Zain-Ul-Islam-Siddiqui/Smart-IoT-Audio-Streaming-System/Design Files/IoT-Speaker-v1.4/Renderings/2D_Top_View.PNG.png

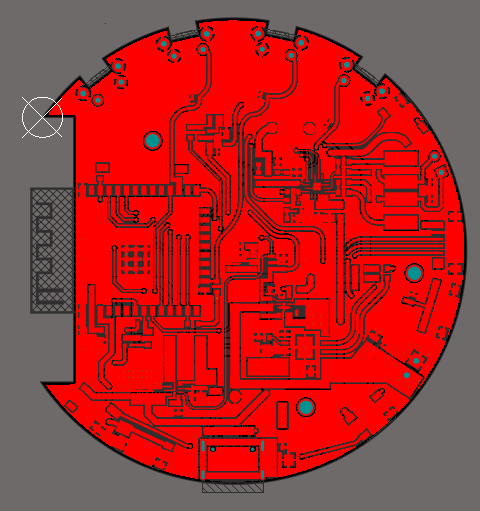
Design Files/IoT-Speaker-v1.4/Renderings/2D_Top_View.PNG.png
