Zain-Ul-Islam-Siddiqui/Smart-IoT-Audio-Streaming-System/Design Files/IoT-Speaker-v1.4/Renderings/3D_Bottom_View.PNG.png

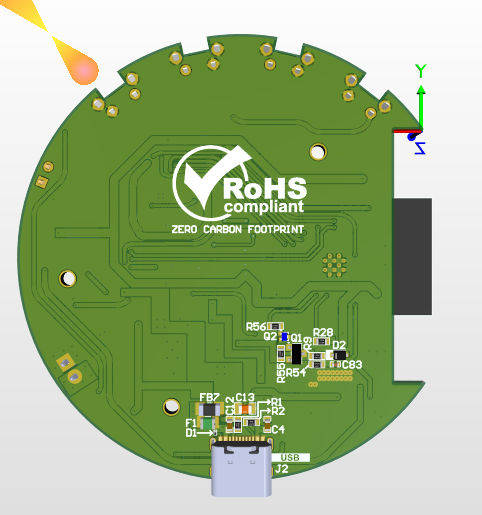
Design Files/IoT-Speaker-v1.4/Renderings/3D_Bottom_View.PNG.png
