Zain-Ul-Islam-Siddiqui/Smart-IoT-Audio-Streaming-System/Design Files/IoT-Speaker-v1.4/BOM/Client BOM IoT-Speaker v1.4.xlsx

 |  | Component list |  | Bill of Materials for Project [IoT-Speaker v1.4]
 |  | Source Data From: |  | IoT-Speaker v1.4
 |  | Project: |  | IoT-Speaker v1.4
 |  | Variant: |  | None
# | Item Type | Designator | Description | Footprint | Manufacturer Part Number | Manufacturer | Value | Links | Quantity | Quantity (5 Boards) | Remarks
1 | Capacitor | C1, C5, C6, C16 | CAP CER 10UF 25V X5R 0805 | Cap-0805 | CC0805KKX5R8BB106 | Yageo | 10uF |  | 4 | 20 | DNP
2 | Capacitor | C2, C3, C7, C18, C20, C83 | CAP CER 0.1UF 25V X5R 0402 | Cap-0402 | CC0402KRX5R8BB104 | Yageo | 100nF |  | 6 | 30 | DNP
3 | Capacitor | C4, C12, C76 | CAP CER 10000PF 50V C0G/NPO 0603 | Cap-0603 | CC0603JRNPO9BN103 | Yageo | 10nF |  | 3 | 15
4 | Capacitor | C9, C15, C17, C19, C21, C22, C24, C78 | CAP CER 10000PF 50V C0G/NPO 0603 | Cap-0402 | CC0402KRX5R8BB104 | Yageo | 100nF |  | 8 | 40
5 | Capacitor | C10, C11 | CAP CER 220PF 50V C0G/NPO 0402 | Cap-0402 | CC0402JRNPO9BN221 | Yageo | 220pF |  | 2 | 10
6 | Capacitor | C13, C103 | CAP CER 10UF 25V X5R 0805 | Cap-0805 | CC0805KKX5R8BB106 | Yageo | 10uF |  | 2 | 10
7 | Capacitor | C14, C75, C102 | CAP CER 1UF 25V X5R 0603 | Cap-0603 | CC0603KRX5R8BB105 | Yageo | 1uF |  | 3 | 15
8 | Capacitor | C23, C77 | CAP CER 22UF 10V X5R 0603 | Cap-0603 | CC0603MRX5R6BB226 | Yageo | 22uF |  | 2 | 10
9 | Capacitor | C25, C26 | CAP CER 22UF 10V X5R 0603 | Cap-0603 | CC0603MRX5R6BB226 | Yageo | 22uF |  | 2 | 10 | DNP
10 | Capacitor | C74 | CAP CER 1UF 25V X5R 0603 | Cap-0603 | CC0603KRX5R8BB105 | Yageo | 1uF |  | 1 | 5 | DNP
11 | Capacitor | C79 | CAP CER 4700PF 1KV X7R 1206 | Cap-1206 | CC1206KKX7RCBB472 | Yageo | 4.7nF |  | 1 | 5
12 | Diode | D1 | TVS DIODE 5VWM 6.3VC DSN0603-2 | DSN0603-2 | PESD5V0H1BSFYL | Nexperia | - |  | 1 | 5
13 | Diode | D2 | DIODE ZENER 3.3V 200MW SOD323F | SOD323F | MM3Z3V3B | ON Semiconductor / Fairchild | - |  | 1 | 5 | DNP
14 | Fuse | F1 | 6V 2A 50A 1W -40℃~+85℃ 4A 4mΩ 5s 45mΩ 0805 Resettable Fuses ROHS | Fuse-0805 | BSMD0805L-200 | BHFUSE | - |  | 1 | 5
15 | Ferrite Bead | FB1, FB2, FB3 | FERRITE BEAD 30 OHM 0603 1LN / Ferrite Beads Multi-Layer 30Ohm 100MHz 1A 0.05Ohm DCR 0603 T/R | IND-0603 (1608 Metric) | BLM18PG300SN1D | Murata | - |  | 3 | 15
16 | Ferrite Bead | FB7 | FERRITE BEAD 120 OHM 1206 1LN | IND-1206 | BLM31PG121SN1L | Murata | - |  | 1 | 5
17 | JST Connector | J1 | Conn Shrouded Header (4 Sides) HDR 2 POS 2.5mm Solder ST Thru-Hole Box | B2B-XH-A(LF)(SN)_ | B2B-XH-A(LF)(SN) | JST | - |  | 1 | 5 | DNP
18 | USB Connector | J2 | 250mA 1 16 Female Type-C SMD USB Connectors ROHS | TYPE-C-31-M-12_ | TYPE-C-31-M-12 | Korean Hroparts Elec | - |  | 1 | 5
19 | Connector | J3 | 1x6P SH 1 1mm 6 SMD,P=1mm Wire To Board / Wire To Wire Connector ROHS | Voltlink Target | C145963 | BOOMELE | - |  | 1 | 5
20 | Header | J9 | CONN HEADER VERT 2POS 2.54MM | HDR1X2_ | 61300211121 | Wurth Electronics | - |  | 1 | 5
21 | INductor | L1 | 5.15A 1uH ±30% SMD Power Inductors ROHS | MPIT6045-1R0N-LF | MPIT6045-1R0N-LF | microgate | 1uH |  | 1 | 5 | DNP
22 | Inductor | L2, L3 | FIXED IND 33UH 500MA 275MOHM SMD | VLCF5024T-330MR50-2 | VLCF5024T-330MR50-2 | TDK | 33uH |  | 2 | 10
23 | LED | LED1 | Emerald 0603 Light Emitting Diodes (LED) ROHS | LED-0603 | NCD0603G2 | Foshan NationStar Optoelectronics | - |  | 1 | 5 | DNP
24 | LED | LED2 | 0603 Light Emitting Diodes (LED) ROHS | LED-0603 | NCD0603R3 | Foshan NationStar Optoelectronics | - |  | 1 | 5 | DNP
25 | RGB LED | LED3, LED4, LED5 | SMD5050 Light Emitting Diodes (LED) ROHS | WS2812B-XF02/W | WS2812B-XF02/W | Worldsemi | - |  | 3 | 15
26 | Mosfet | Q1 | 30V 4.1A 60mΩ@10V,4.1A 350mW 3V@250uA P Channel SOT-23 MOSFETs ROHS | SOT-23 | AO3407 | Guangdong Hottech | - |  | 1 | 5 | DNP
27 | Mosfet | Q2 | 40V 100mW 100@10mA,1V 200mA 300MHz 300mV@50mA,5mA NPN -55℃~+150℃@(Tj) SOT-723 Bipolar Transistors - BJT ROHS | SOT-723 | MMBT3904M | TECH PUBLIC | - |  | 1 | 5 | DNP
28 | Mosfet | Q3 | 40V 100mW 100@10mA,1V 200mA 300MHz 300mV@50mA,5mA NPN -55℃~+150℃@(Tj) SOT-723 Bipolar Transistors - BJT ROHS | SOT-723 | MMBT3904M | TECH PUBLIC | - |  | 1 | 5
29 | Mosfet | Q6 | N-CHANNEL 20-V (D-S) MOSFET | Sot-23 | SI2302CDS | TECH PUBLIC | - |  | 1 | 5
30 | Resistor | R1, R2 | RES 5.1K OHM 1% 1/10W 0603 | Res-0603 | RC0603FR-075K1L | Yageo | 5.1K |  | 2 | 10
31 | Resistor | R4 | RES SMD 330R 100 mW 0603 | Res-0603 | RC0603JR-07330RL | Yageo | 330R |  | 1 | 5 | DNP
32 | Resistor | R5 | Thick Film Resistors 75V 1.2kΩ 0603 Chip Resistor - Surface Mount ROHS | Res-0603 | 0603WAF1201T5E | UNI-ROYAL | 1.2K |  | 1 | 5 | DNP
33 | Resistor | R6 | RES SMD 10K Ohm 1% 1/10W 0603 | Res-0603 | RC0603FR-0710KL | Yageo | 10K |  | 1 | 5 | DNP
34 | Resistor | R7 | ±1% 732kΩ 0402 Chip Resistor - Surface Mount ROHS | Res-0402 | FRC0402F7323TS | FOJAN | 732K |  | 1 | 5 | DNP
35 | Resistor | R8 | RES SMD 100K OHM 0.1% 1/10W 0603 | Res-0603 | RT0603BRD07100KL | Yageo | 100K |  | 1 | 5 | DNP
36 | Resistor | R9, R54 | RES 47K OHM 5% 1/10W 0603 | Res-0603 | RC0603JR-0747KL | Yageo | 47K |  | 2 | 10 | DNP
37 | Resistor | R10, R11 | RES SMD 4.7K OHM 5% 1/10W 0603 | Res-0603 | RC0603JR-074K7L | Yageo | 4.7K |  | 2 | 10
38 | Resistor | R12 | RES 47K OHM 5% 1/10W 0603 | Res-0603 | RC0603JR-0747KL | Yageo | 47K |  | 1 | 5
39 | Resistor | R13, R14 | RES 0 OHM JUMPER 1/10W 0603 | Res-0603 | RC0603JR-070RL | Yageo | 0R |  | 2 | 10
40 | Resistor | R18, R19, R20, R21, R22 | RES SMD 10K Ohm 1% 1/10W 0603 | Res-0603 | RC0603FR-0710KL | Yageo | 10K |  | 5 | 25
41 | Resistor | R26, R27 | RES 10K OHM 1% 1/16W 0402 | Res-0402 | RC0402FR-0710KL | Yageo | 10K |  | 2 | 10
42 | Resistor | R28 | RES SMD 1K OHM 1% 1/10W 0603 | Res-0603 | RC0603FR-071KL | Yageo | 1K |  | 1 | 5
43 | Resistor | R29, R31, R34, R36, R37, R38 | RES SMD 0R, 1%, 0.1W, 0603 | Res-0603 | RC0603FR-070RL | Yageo | 0R |  | 6 | 30 | DNP
44 | Resistor | R30, R32, R35, R39 | RES SMD 0R, 1%, 0.1W, 0603 | Res-0603 | RC0603FR-070RL | Yageo | 0R |  | 4 | 20
45 | Resistor | R55 | RES SMD 1K OHM 1% 1/10W 0603 | Res-0603 | RC0603FR-071KL | Yageo | 1K |  | 1 | 5 | DNP
46 | Resistor | R56 | RES SMD 4.7K OHM 5% 1/10W 0603 | Res-0603 | RC0603JR-074K7L | Yageo | 4.7K |  | 1 | 5 | DNP
47 | Resistor | R65, R69 | RES SMD 1M OHM 1% 1/10W 0603 | Res-0603 | RC0603FR-071ML | Yageo | 1M |  | 2 | 10
48 | Resistor | R66, R67 | RES SMD 100K OHM 0.1% 1/10W 0603 | Res-0603 | RT0603BRD07100KL | Yageo | 100K |  | 2 | 10
49 | Switch | SW1 | No NO 50mA 4.5mm 100000 260gf 12V -30℃~+85℃ 4.5mm 4.3mm Black Round Button Brick nogging SPST SMD Tactile Switches ROHS | TS-1109S-C-B | TS-1109S-C-B | XKB Connectivity | - |  | 1 | 5
50 | Tactile Switch | SW4, SW5, SW6, SW8 | Plugin-4P,7.7x3.5mm Tactile Switches ROHS | TS-1087E-B3D2 | TS-1087E-B3D2 | Yuandy | - |  | 4 | 20
51 | Switch | SW7 | No NO 50mA 4.5mm 100000 160gf 12V -30℃~+85℃ 4.5mm 8mm Black Round Button Brick nogging SPST SMD Tactile Switches ROHS | TS-1109S-B-J_ | TS-1109S-B-J | XKB Connectivity | - |  | 1 | 5
52 | Mosfet | U1 | ESOP-8 Battery Management ICs ROHS | ESOP-8 | TP4056-42-ESOP8 | TOPPOWER | - |  | 1 | 5
53 | IC | U2 | OR Controller N+1 ORing Controller N-Channel 2:1 SOT-583 | SOT-583 | LM66200DRLR | Texas Instruments | - |  | 1 | 5 | DNP
54 | IC | U3 | 8-A boost converter with 0.5-V ultra-low input voltage 7-VQFN-HR -40 to 125 | 7-VQFN-HR (2x2) | TPS61022RWUR | Texas Instruments | - |  | 1 | 5 | DNP
55 | Module | U4 | RF TXRX MODULE BT PCB TRACE SMD | 38-SMD Module | ESP32-WROOM-32E-N8R2 | Espressif Systems | - |  | 1 | 5
56 | IC | U7 | SPX3819 Series 3.3 V 500 mA Fixed Output SMT LDO Regulator - SOT-23-5 | SOT-23-5 | SPX3819M5-L-3-3/TR | MaxLinear | - |  | 1 | 5
57 | IC | U8 | IC CNTRLR ON/OFF W/DEB TSOT23-6 | TSOT-23-6 | MAX16054AZT+T | Maxim | - |  | 1 | 5
58 | IC | U16 | Audio Amplifier, 1 Func, PQCC16 | TQFN-16-EP(3x3) | MAX98357AETE+T | Maxim | - |  | 1 | 5
59 | Speaker | Peripheral | Speakers ROHS | - | FS40DS0430-H18.8 |  |  |  | 1 | 5
60 | Battery | Peripheral | 803450 3.7V 1500mAh Lithium Polymer Rechargeable Battery For MP3 GPS Massager Camera Power Bank Laptop Speaker Lipo Li ion Cell | - | - | - | - | Aliexpress (https://vi.aliexpress.com/item/1005006415551699.html) | 1 | 5
61 | USB Cable | Peripheral | 3A USB Type C Fast Charging Cable Quick Charger QC3.0 USB C Data Cable for Xiaomi Huawei Samsung Tablets Laptops 1M | - | - | - | - | Aliexpress (https://vi.aliexpress.com/item/1005006383634012.html?utparam-url=scene%3Asearch%7Cquery_from%3A) | 1 | 1
62 | Screw | Peripheral | M2 Thread Length 16mm/ Head Dia 4mm | - | M2 (16mm) | - | - | Aliexpress (https://vi.aliexpress.com/item/32810852732.html?pdp_npi=4) | 3 | 15
63 |  |  | M3 Thread Length 20mm/ Head Dia 5.6mm | - | M3 (20mm) | - | - | Aliexpress (https://vi.aliexpress.com/item/32810852732.html?pdp_npi=4) | 2 | 10
64 |  |  | M Thread Length 4mm/ Head Dia 5.6mm | - | M3 (4mm) | - | - | Aliexpress (https://vi.aliexpress.com/item/32810852732.html?pdp_npi=4) | 4 | 20
