Zain-Ul-Islam-Siddiqui/Smart-IoT-Audio-Streaming-System/Design Files/IoT-Speaker-v1.4/BOM/eSpark BOM IoT-Speaker v1.3.xlsx

Sheet: 5 Boards
 |  | Component list |  | Bill of Materials for Project [IoT-Speaker v1.3]
 |  | Source Data From: |  | IoT-Speaker v1.3
 |  | Project: |  | IoT-Speaker v1.3
 |  | Variant: |  | None
# | Item Type | Designator | Description | Footprint | Manufacturer Part Number | Manufacturer | Alternate Part Number | LCSC Part Number | Value | Quantity | Quantity (5 Boards) | MOQ (5 Boards) | Links | Unit Cost (5 Boards) | Total Cost (5 Boards) | Remarks | Reviewer Remarks
1 | Capacitor | C1, C5, C6, C13, C16, C103 | CAP CER 10UF 25V X5R 0805 | Cap-0805 | CC0805KKX5R8BB106 | Yageo | - | C89831 | 10uF | 6 | 30 | 40 | LCSC (https://www.lcsc.com/product-detail/Multilayer-Ceramic-Capacitors-MLCC-SMD-SMT_YAGEO-CC0805KKX5R8BB106_C89831.html) | $0.0355 | $1.4200
2 | Capacitor | C2, C3, C7, C9, C15, C17, C18, C19, C20, C21, C22, C24, C78, C83 | CAP CER 0.1UF 25V X5R 0402 | Cap-0402 | CC0402KRX5R8BB104 | Yageo | - | C106256 | 100nF | 14 | 70 | 100 | LCSC (https://www.lcsc.com/product-detail/Multilayer-Ceramic-Capacitors-MLCC-SMD-SMT_YAGEO-CC0402KRX5R8BB104_C106256.html) | $0.0018 | $0.1800
3 | Capacitor | C4, C12, C76 | CAP CER 10000PF 50V C0G/NPO 0603 | Cap-0603 | CC0603JRNPO9BN103 | Yageo | - | C389113 | 10nF | 3 | 15 | 50 | LCSC (https://www.lcsc.com/product-detail/Multilayer-Ceramic-Capacitors-MLCC-SMD-SMT_YAGEO-CC0603JRNPO9BN103_C389113.html) | $0.0166 | $0.8300
4 | Capacitor | C10, C11 | CAP CER 220PF 50V C0G/NPO 0402 | Cap-0402 | CC0402JRNPO9BN221 | Yageo | - | C107001 | 220pF | 2 | 10 | 100 | LCSC (https://www.lcsc.com/product-detail/Multilayer-Ceramic-Capacitors-MLCC-SMD-SMT_YAGEO-CC0402JRNPO9BN221_C107001.html) | $0.0023 | $0.2300
5 | Capacitor | C14, C74, C75, C102 | CAP CER 1UF 25V X5R 0603 | Cap-0603 | CC0603KRX5R8BB105 | Yageo | - | C14664 | 1uF | 4 | 20 | 100 | LCSC (https://www.lcsc.com/product-detail/Multilayer-Ceramic-Capacitors-MLCC-SMD-SMT_YAGEO-CC0603KRX5R8BB105_C14664.html) | $0.0052 | $0.5200
6 | Capacitor | C23, C25, C26, C77 | CAP CER 22UF 10V X5R 0603 | Cap-0603 | CC0603MRX5R6BB226 | Yageo | - | C109447 | 22uF | 4 | 20 | 40 | LCSC (https://www.lcsc.com/product-detail/Multilayer-Ceramic-Capacitors-MLCC-SMD-SMT_YAGEO-CC0603MRX5R6BB226_C109447.html) | $0.0452 | $1.8080
7 | Capacitor | C79 | CAP CER 4700PF 1KV X7R 1206 | Cap-1206 | CC1206KKX7RCBB472 | Yageo | - | C107198 | 4.7nF | 1 | 5 | 50 | LCSC (https://www.lcsc.com/product-detail/Multilayer-Ceramic-Capacitors-MLCC-SMD-SMT_YAGEO-CC1206KKX7RCBB472_C107198.html) | $0.0191 | $0.9550
8 | Diode | D1 | TVS DIODE 5VWM 6.3VC DSN0603-2 | DSN0603-2 | PESD5V0H1BSFYL | Nexperia | - | C477989 | - | 1 | 5 | 10 | LCSC (https://www.lcsc.com/product-detail/ESD-Protection-Devices_Nexperia-PESD5V0H1BSF_C477989.html) | $0.0341 | $0.3410
9 | Diode | D2 | DIODE ZENER 3.3V 200MW SOD323F | SOD323F | MM3Z3V3B | ON Semiconductor / Fairchild | - | C2978865 | - | 1 | 5 | 10 | LCSC (https://www.lcsc.com/product-detail/Zener-Diodes_EIC-Semicon-MM3Z3V3B_C2978865.html) | $0.0404 | $0.4040
10 | Fuse | F1 | 6V 2A 50A 1W -40℃~+85℃ 4A 4mΩ 5s 45mΩ 0805 Resettable Fuses ROHS | Fuse-0805 | BSMD0805L-200 | BHFUSE | - | C2757931 | - | 1 | 5 | 10 | LCSC (https://www.lcsc.com/product-detail/Resettable-Fuses_BHFUSE-BSMD0805L-200_C2757931.html) | $0.0933 | $0.9330
11 | Ferrite Bead | FB1, FB2, FB3 | FERRITE BEAD 30 OHM 0603 1LN / Ferrite Beads Multi-Layer 30Ohm 100MHz 1A 0.05Ohm DCR 0603 T/R | IND-0603 (1608 Metric) | BLM18PG300SN1D | Murata | - | C17305 | - | 3 | 15 | 100 | LCSC (https://www.lcsc.com/product-detail/Ferrite-Beads_Murata-Electronics-BLM18PG300SN1D_C17305.html) | $0.0071 | $0.7100
12 | Ferrite Bead | FB7 | FERRITE BEAD 120 OHM 1206 1LN | IND-1206 | BLM31PG121SN1L | Murata | - | C85841 | 100MHz | 1 | 5 | 10 | LCSC (https://www.lcsc.com/product-detail/Ferrite-Beads_Murata-Electronics-BLM31PG121SN1L_C85841.html) | $0.0669 | $0.6690
13 | JST Connector | J1 | Conn Shrouded Header (4 Sides) HDR 2 POS 2.5mm Solder ST Thru-Hole Box | B2B-XH-A(LF)(SN)_ | B2B-XH-A(LF)(SN) | JST | - | C158012 | - | 1 | 5 | 20 | LCSC (https://www.lcsc.com/product-detail/Wire-To-Board-Wire-To-Wire-Connector_JST-Sales-America-B2B-XH-A-LF-SN_C158012.html) | $0.0328 | $0.6560
14 | USB Connector | J2 | 250mA 1 16 Female Type-C SMD USB Connectors ROHS | TYPE-C-31-M-12_ | TYPE-C-31-M-12 | Korean Hroparts Elec | - | C165948 | - | 1 | 5 | 10 | LCSC (https://www.lcsc.com/product-detail/USB-Connectors_Korean-Hroparts-Elec-TYPE-C-31-M-12_C165948.html) | $0.1612 | $1.6120
15 | Connector | J3 | 1x6P SH 1 1mm 6 SMD,P=1mm Wire To Board / Wire To Wire Connector ROHS | Voltlink Target | C145963 | BOOMELE | - | C145963 | - | 1 | 5 | 12 | LCSC (https://www.lcsc.com/product-detail/Wire-To-Board-Wire-To-Wire-Connector_BOOMELE-Boom-Precision-Elec-C145963_C145963.html) | $0.0680 | $0.8160
16 | Header | J9 | CONN HEADER VERT 2POS 2.54MM | HDR1X2_ | ~~61300211121~~ | Wurth Electronics | B-2100S02P-A110 | C124375 | - | 1 | 5 | 20 | LCSC (https://www.lcsc.com/product-detail/span-style-background-color-ff0-Pin-span-Headers_Ckmtw-Shenzhen-Cankemeng-B-2100S02P-A110_C124375.html) | $0.0220 | $0.4400
17 | INductor | L1 | 5.15A 1uH ±30% SMD Power Inductors ROHS | MPIT6045-1R0N-LF | MPIT6045-1R0N-LF | microgate | - | C486570 | 1uH | 1 | 5 | 10 | LCSC (https://www.lcsc.com/product-detail/Power-Inductors_microgate-MPIT6045-1R0N-LF_C486570.html) | $0.0726 | $0.7260
18 | Inductor | L2, L3 | FIXED IND 33UH 500MA 275MOHM SMD | VLCF5024T-330MR50-2 | VLCF5024T-330MR50-2 | TDK | - | C2046704 | 33uH | 2 | 10 | 11 | LCSC (https://www.lcsc.com/product-detail/Inductors-SMD_TDK-VLCF5024T-330MR50-2_C2046704.html) | $0.4169 | $4.5859
19 | LED | LED2 | 0603 Light Emitting Diodes (LED) ROHS | LED-0603 | NCD0603R3 | Foshan NationStar Optoelectronics | - | C3151730 | - | 1 | 5 | 20 | LCSC (https://www.lcsc.com/product-detail/Light-Emitting-Diodes-LED_Foshan-NationStar-Optoelectronics-NCD0603R3_C3151730.html) | $0.0208 | $0.4160
20 | RGB LED | LED3, LED4, LED5 | SMD5050 Light Emitting Diodes (LED) ROHS | WS2812B-XF02/W | WS2812B-XF02/W | Worldsemi | - | C4154882 | - | 3 | 15 | 20 | LCSC (https://www.lcsc.com/product-detail/Light-Emitting-Diodes-LED_Worldsemi-WS2812B-XF02-W_C4154882.html) | $0.0617 | $1.2340
21 | Mosfet | Q1 | 30V 4.1A 60mΩ@10V,4.1A 350mW 3V@250uA P Channel SOT-23 MOSFETs ROHS | SOT-23 | AO3407 | Guangdong Hottech | - | C181093 | - | 1 | 5 | 20 | LCSC (https://www.lcsc.com/product-detail/MOSFETs_Guangdong-Hottech-AO3407_C181093.html) | $0.0325 | $0.6500
22 | Mosfet | Q2, Q3 | 40V 100mW 100@10mA,1V 200mA 300MHz 300mV@50mA,5mA NPN -55℃~+150℃@(Tj) SOT-723 Bipolar Transistors - BJT ROHS | SOT-723 | MMBT3904M | TECH PUBLIC | - | C2923360 | - | 2 | 10 | 20 | LCSC (https://www.lcsc.com/product-detail/Bipolar-Transistors-BJT_TECH-PUBLIC-MMBT3904M_C2923360.html) | $0.0335 | $0.6700
23 | Mosfet | Q6 | N-CHANNEL 20-V (D-S) MOSFET | Sot-23 | SI2302CDS | TECH PUBLIC | - | C5310968 | - | 1 | 5 | 20 | LCSC (https://www.lcsc.com/product-detail/MOSFETs_TECH-PUBLIC-SI2302CDS_C5310968.html) | $0.0341 | $0.6820
24 | Resistor | R1, R2 | RES 5.1K OHM 1% 1/10W 0603 | Res-0603 | RC0603FR-075K1L | Yageo | - | C105580 | 5.1K | 2 | 10 | 100 | LCSC (https://www.lcsc.com/product-detail/Chip-Resistor-Surface-Mount_YAGEO-RC0603FR-075K1L_C105580.html) | $0.0013 | $0.1300
25 | Resistor | R4 | RES SMD 330R 100 mW 0603 | Res-0603 | RC0603JR-07330RL | Yageo | - | C105879 | 330R | 1 | 5 | 100 | LCSC (https://www.lcsc.com/product-detail/Chip-Resistor-Surface-Mount_YAGEO-RC0603JR-07330RL_C105879.html) | $0.0011 | $0.1100
26 | Resistor | R5 | Thick Film Resistors 75V 1.2kΩ 0603 Chip Resistor - Surface Mount ROHS | Res-0603 | 0603WAF1201T5E | UNI-ROYAL | - | C22765 | 1.2K | 1 | 5 | 100 | LCSC (https://www.lcsc.com/product-detail/Chip-Resistor-Surface-Mount_UNI-ROYAL-Uniroyal-Elec-0603WAF1201T5E_C22765.html) | $0.0011 | $0.1100
27 | Resistor | R6, R18, R19, R20, R21, R22 | RES SMD 10K Ohm 1% 1/10W 0603 | Res-0603 | RC0603FR-0710KL | Yageo | - | C98220 | 10K | 6 | 30 | 100 | LCSC (https://www.lcsc.com/product-detail/Chip-Resistor-Surface-Mount_YAGEO-RC0603FR-0710KL_C98220.html) | $0.0010 | $0.1000
28 | Resistor | R7 | ±1% 732kΩ 0402 Chip Resistor - Surface Mount ROHS | Res-0402 | FRC0402F7323TS | FOJAN | - | C5159692 | 732K | 1 | 5 | 10 | LCSC (https://www.lcsc.com/product-detail/Chip-Resistor-Surface-Mount_FOJAN-FRC0402F7323TS_C5159692.html) | $0.0004 | $0.0040
29 | Resistor | R8, R66, R67 | RES SMD 100K OHM 0.1% 1/10W 0603 | Res-0603 | RT0603BRD07100KL | Yageo | - | C122538 | 100K | 3 | 15 | 20 | LCSC (https://www.lcsc.com/product-detail/Chip-Resistor-Surface-Mount_YAGEO-RT0603BRD07100KL_C122538.html) | $0.0211 | $0.4220
30 | Resistor | R9, R12, R54 | RES 47K OHM 5% 1/10W 0603 | Res-0603 | RC0603JR-0747KL | Yageo | - | C127447 | 47K | 3 | 15 | 100 | LCSC (https://www.lcsc.com/product-detail/Chip-Resistor-Surface-Mount_YAGEO-RC0603JR-0747KL_C127447.html) | $0.0011 | $0.1100
31 | Resistor | R10, R11, R56 | RES SMD 4.7K OHM 5% 1/10W 0603 | Res-0603 | RC0603JR-074K7L | Yageo | - | C105428 | 4.7K | 3 | 15 | 100 | LCSC (https://www.lcsc.com/product-detail/Chip-Resistor-Surface-Mount_YAGEO-RC0603JR-074K7L_C105428.html) | $0.0011 | $0.1100
32 | Resistor | R26, R27 | RES 10K OHM 1% 1/16W 0402 | Res-0402 | RC0402FR-0710KL | Yageo | - | C60490 | 10K | 2 | 10 | 100 | LCSC (https://www.lcsc.com/product-detail/Chip-Resistor-Surface-Mount_YAGEO-RC0402FR-0710KL_C60490.html) | $0.0006 | $0.0600
33 | Resistor | R28, R55 | RES SMD 1K OHM 1% 1/10W 0603 | Res-0603 | RC0603FR-071KL | Yageo | - | C22548 | 1K | 2 | 10 | 100 | LCSC (https://www.lcsc.com/product-detail/Chip-Resistor-Surface-Mount_YAGEO-RC0603FR-071KL_C22548.html) | $0.0010 | $0.1000
34 | Resistor | R30, R32, R35, R39 | RES SMD 0R, 1%, 0.1W, 0603 | Res-0603 | ~~RC0603FR-070RL~~ | Yageo | 0603WAF0000T5E | C21189 | 0R | 4 | 20 | 100 | LCSC (https://www.lcsc.com/product-detail/Chip-Resistor-Surface-Mount_UNI-ROYAL-Uniroyal-Elec-0603WAF0000T5E_C21189.html) | $0.0011 | $0.1100
35 | Resistor | R65, R69 | RES SMD 1M OHM 1% 1/10W 0603 | Res-0603 | RC0603FR-071ML | Yageo | - | C105578 | 1M | 2 | 10 | 100 | LCSC (https://www.lcsc.com/product-detail/Chip-Resistor-Surface-Mount_YAGEO-RC0603FR-071ML_C105578.html) | $0.0012 | $0.1200
36 | Switch | SW1 | No NO 50mA 4.5mm 100000 260gf 12V -30℃~+85℃ 4.5mm 4.3mm Black Round Button Brick nogging SPST SMD Tactile Switches ROHS | TS-1109S-C-B | TS-1109S-C-B | XKB Connectivity | - | C381037 | - | 1 | 5 | 20 | LCSC (https://www.lcsc.com/product-detail/Tactile-Switches_XKB-Connectivity-TS-1109S-C-B_C381037.html) | $0.0217 | $0.4340
37 | Tactile Switch | SW4, SW5, SW6, SW8 | Plugin-4P,7.7x3.5mm Tactile Switches ROHS | TS-1087E-B3D2 | TS-1087E-B3D2 | Yuandi | - | - | - | 4 | 20 | 21 | LCSC (https://www.lcsc.com/product-detail/Tactile-Switches_Yuandi-TS-1087E-B3D2_C541963.html) | $0.6100 | $12.8100
38 | Switch | SW7 | No NO 50mA 4.5mm 100000 160gf 12V -30℃~+85℃ 4.5mm 8mm Black Round Button Brick nogging SPST SMD Tactile Switches ROHS | TS-1109S-B-J_ | TS-1109S-B-J | XKB Connectivity | - | C480323 | - | 1 | 5 | 10 | LCSC (https://www.lcsc.com/product-detail/Tactile-Switches_XKB-Connectivity-TS-1109S-B-J_C480323.html) | $0.0402 | $0.4020
39 | Mosfet | U1 | ESOP-8 Battery Management ICs ROHS | ESOP-8 | TP4056-42-ESOP8 | TOPPOWER | - | C16581 | - | 1 | 5 | 10 | LCSC (https://www.lcsc.com/product-detail/Battery-Management-ICs_TOPPOWER-Nanjing-Extension-Microelectronics-TP4056-42-ESOP8_C16581.html) | $0.1760 | $1.7600
40 | IC | U2 | OR Controller N+1 ORing Controller N-Channel 2:1 SOT-583 | SOT-583 | LM66200DRLR | Texas Instruments | - | C3235556 | - | 1 | 5 | 6 | LCSC (https://www.lcsc.com/product-detail/Power-Distribution-Switches_Texas-Instruments-LM66200DRLR_C3235556.html) | $0.4169 | $2.5014
41 | IC | U3 | 8-A boost converter with 0.5-V ultra-low input voltage 7-VQFN-HR -40 to 125 | 7-VQFN-HR (2x2) | TPS61022RWUR | Texas Instruments | - | C915088 | - | 1 | 5 | 6 | LCSC (https://www.lcsc.com/product-detail/DC-DC-Converters_Texas-Instruments-TPS61022RWUR_C915088.html) | $0.6046 | $3.6276
42 | Module | U4 | RF TXRX MODULE BT PCB TRACE SMD | 38-SMD Module | ESP32-WROOM-32E-N8R2 | Espressif Systems | - | C5361945 | - | 1 | 5 | 6 | LCSC (https://www.lcsc.com/product-detail/WiFi-Modules_Espressif-Systems-ESP32-WROOM-32E-N8R2_C5361945.html) | $3.3075 | $19.8450
43 | IC | U7 | SPX3819 Series 3.3 V 500 mA Fixed Output SMT LDO Regulator - SOT-23-5 | SOT-23-5 | SPX3819M5-L-3-3/TR | MaxLinear | - | C9055 | - | 1 | 5 | 6 | LCSC (https://www.lcsc.com/product-detail/Linear-Voltage-Regulators-LDO_MaxLinear-SPX3819M5-L-3-3-TR_C9055.html) | $0.1268 | $0.7608
44 | IC | U8 | IC CNTRLR ON/OFF W/DEB TSOT23-6 | TSOT-23-6 | MAX16054AZT+T | Maxim | - | C79401 | - | 1 | 5 | 6 | LCSC (https://www.lcsc.com/product-detail/Interface-Specialized_Analog-Devices-MAX16054AZT-T_C79401.html) | $1.4398 | $8.6388
45 | IC | U16 | Audio Amplifier, 1 Func, PQCC16 | TQFN-16-EP(3x3) | MAX98357AETE+T | Maxim | - | C910544 | - | 1 | 5 | 6 | LCSC (https://www.lcsc.com/product-detail/Audio-Power-OpAmps_Analog-Devices-Inc-Maxim-Integrated-MAX98357AETE-T_C910544.html) | $1.0500 | $6.3000
46 | Speaker | Peripheral | Speakers ROHS | - | FS40DS0430-H18.8 | - | - | C969979 | - | 1 | 5 | 6 | LCSC (https://www.lcsc.com/product-detail/Speakers_FUET-FS40DS0430-H18-8_C969979.html) | $1.9410 | $11.6460
47 | Battery | Peripheral | 803450 3.7V 1500mAh Lithium Polymer Rechargeable Battery For MP3 GPS Massager Camera Power Bank Laptop Speaker Lipo Li ion Cell | - | - | - | - | - | - | 1 | 5 | 5 | Aliexpress (https://vi.aliexpress.com/item/1005006415551699.html) | $3.0800 | $15.4000
48 | Charger | Peripheral | Universal 5V 1A 2A Type C USB Charger Mobile Phone Wall Travel Power Adapter Charger EU/US Plug For Huawei Xiaomi iPhone Samsung (2A Rating Selected) | - | - | - | - | - | - | 1 | 5 | 1 | Aliexpress (https://vi.aliexpress.com/item/1005005257036835.html) | $0.6600 | $0.6600
49 | Screw | Peripheral | M2 Thread Length 16mm/ Head Dia 4mm | - | M2 (16mm) | - | - | - | - | 3 | 15 | 50 | Aliexpress (https://vi.aliexpress.com/item/32810852732.html?pdp_npi=4) | $0.0254 | $1.2700
50 |  |  | M3 Thread Length 20mm/ Head Dia 5.6mm | - | M3 (20mm) | - | - | - | - | 2 | 10 | 50 | Aliexpress (https://vi.aliexpress.com/item/32810852732.html?pdp_npi=4) | $0.0368 | $1.8400
51 |  |  | M Thread Length 4mm/ Head Dia 5.6mm | - | M3 (4mm) | - | - | - | - | 4 | 20 | 50 | Aliexpress (https://vi.aliexpress.com/item/32810852732.html?pdp_npi=4) | $0.0144 | $0.7200
 |  |  |  |  |  |  |  |  |  |  |  | Total Component Cost |  |  | $111.59
 |  |  |  |  |  |  |  |  |  |  |  | Single Board Cost |  |  | $22.32

Sheet: 100 Boards
 |  | Component list |  | Bill of Materials for Project [IoT-Speaker v1.3]
 |  | Source Data From: |  | IoT-Speaker v1.3
 |  | Project: |  | IoT-Speaker v1.3
 |  | Variant: |  | None
# | Item Type | Designator | Description | Footprint | Manufacturer Part Number | Manufacturer | Alternate Part Number | LCSC Part Number | Value | Quantity | Quantity (100 Boards) | MOQ (100 Boards) | Links | Unit Cost (100 Boards) | Total Cost (100 Boards) | Remarks | Reviewer Remarks
1 | Capacitor | C1, C5, C6, C13, C16, C103 | CAP CER 10UF 25V X5R 0805 | Cap-0805 | CC0805KKX5R8BB106 | Yageo | - | C89831 | 10uF | 6 | 600 | 620 | LCSC (https://www.lcsc.com/product-detail/Multilayer-Ceramic-Capacitors-MLCC-SMD-SMT_YAGEO-CC0805KKX5R8BB106_C89831.html) | $0.0258 | $15.9960
2 | Capacitor | C2, C3, C7, C9, C15, C17, C18, C19, C20, C21, C22, C24, C78, C83 | CAP CER 0.1UF 25V X5R 0402 | Cap-0402 | CC0402KRX5R8BB104 | Yageo | - | C106256 | 100nF | 14 | 1400 | 1500 | LCSC (https://www.lcsc.com/product-detail/Multilayer-Ceramic-Capacitors-MLCC-SMD-SMT_YAGEO-CC0402KRX5R8BB104_C106256.html) | $0.0015 | $2.2500
3 | Capacitor | C4, C12, C76 | CAP CER 10000PF 50V C0G/NPO 0603 | Cap-0603 | CC0603JRNPO9BN103 | Yageo | - | C389113 | 10nF | 3 | 300 | 350 | LCSC (https://www.lcsc.com/product-detail/Multilayer-Ceramic-Capacitors-MLCC-SMD-SMT_YAGEO-CC0603JRNPO9BN103_C389113.html) | $0.0166 | $5.8100
4 | Capacitor | C10, C11 | CAP CER 220PF 50V C0G/NPO 0402 | Cap-0402 | CC0402JRNPO9BN221 | Yageo | - | C107001 | 220pF | 2 | 200 | 300 | LCSC (https://www.lcsc.com/product-detail/Multilayer-Ceramic-Capacitors-MLCC-SMD-SMT_YAGEO-CC0402JRNPO9BN221_C107001.html) | $0.0023 | $0.6900
5 | Capacitor | C14, C74, C75, C102 | CAP CER 1UF 25V X5R 0603 | Cap-0603 | CC0603KRX5R8BB105 | Yageo | - | C14664 | 1uF | 4 | 400 | 500 | LCSC (https://www.lcsc.com/product-detail/Multilayer-Ceramic-Capacitors-MLCC-SMD-SMT_YAGEO-CC0603KRX5R8BB105_C14664.html) | $0.0059 | $2.9500
6 | Capacitor | C23, C25, C26, C77 | CAP CER 22UF 10V X5R 0603 | Cap-0603 | CC0603MRX5R6BB226 | Yageo | - | C109447 | 22uF | 4 | 400 | 410 | LCSC (https://www.lcsc.com/product-detail/Multilayer-Ceramic-Capacitors-MLCC-SMD-SMT_YAGEO-CC0603MRX5R6BB226_C109447.html) | $0.0421 | $17.2610
7 | Capacitor | C79 | CAP CER 4700PF 1KV X7R 1206 | Cap-1206 | CC1206KKX7RCBB472 | Yageo | - | C107198 | 4.7nF | 1 | 100 | 150 | LCSC (https://www.lcsc.com/product-detail/Multilayer-Ceramic-Capacitors-MLCC-SMD-SMT_YAGEO-CC1206KKX7RCBB472_C107198.html) | $0.0191 | $2.8650
8 | Diode | D1 | TVS DIODE 5VWM 6.3VC DSN0603-2 | DSN0603-2 | PESD5V0H1BSFYL | Nexperia | - | C477989 | - | 1 | 100 | 110 | LCSC (https://www.lcsc.com/product-detail/ESD-Protection-Devices_Nexperia-PESD5V0H1BSF_C477989.html) | $0.0274 | $3.0140
9 | Diode | D2 | DIODE ZENER 3.3V 200MW SOD323F | SOD323F | MM3Z3V3B | ON Semiconductor / Fairchild | - | C2978865 | - | 1 | 100 | 110 | LCSC (https://www.lcsc.com/product-detail/Zener-Diodes_EIC-Semicon-MM3Z3V3B_C2978865.html) | $0.0404 | $4.4440
10 | Fuse | F1 | 6V 2A 50A 1W -40℃~+85℃ 4A 4mΩ 5s 45mΩ 0805 Resettable Fuses ROHS | Fuse-0805 | BSMD0805L-200 | BHFUSE | - | C2757931 | - | 1 | 100 | 105 | LCSC (https://www.lcsc.com/product-detail/Resettable-Fuses_BHFUSE-BSMD0805L-200_C2757931.html) | $0.0760 | $7.9800
11 | Ferrite Bead | FB1, FB2, FB3 | FERRITE BEAD 30 OHM 0603 1LN / Ferrite Beads Multi-Layer 30Ohm 100MHz 1A 0.05Ohm DCR 0603 T/R | IND-0603 (1608 Metric) | BLM18PG300SN1D | Murata | - | C17305 | - | 3 | 300 | 400 | LCSC (https://www.lcsc.com/product-detail/Ferrite-Beads_Murata-Electronics-BLM18PG300SN1D_C17305.html) | $0.0071 | $2.8400
12 | Ferrite Bead | FB7 | FERRITE BEAD 120 OHM 1206 1LN | IND-1206 | BLM31PG121SN1L | Murata | - | C85841 | 100MHz | 1 | 100 | 110 | LCSC (https://www.lcsc.com/product-detail/Ferrite-Beads_Murata-Electronics-BLM31PG121SN1L_C85841.html) | $0.0552 | $6.0720
13 | JST Connector | J1 | Conn Shrouded Header (4 Sides) HDR 2 POS 2.5mm Solder ST Thru-Hole Box | Custom | B2B-XH-A(LF)(SN) | JST | - | C158012 | - | 1 | 100 | 120 | LCSC (https://www.lcsc.com/product-detail/Wire-To-Board-Wire-To-Wire-Connector_JST-Sales-America-B2B-XH-A-LF-SN_C158012.html) | $0.0328 | $3.9360
14 | USB Connector | J2 | 250mA 1 16 Female Type-C SMD USB Connectors ROHS | Custom | TYPE-C-31-M-12 | Korean Hroparts Elec | - | C165948 | - | 1 | 100 | 105 | LCSC (https://www.lcsc.com/product-detail/USB-Connectors_Korean-Hroparts-Elec-TYPE-C-31-M-12_C165948.html) | $0.1282 | $13.4610
15 | Connector | J3 | 1x6P SH 1 1mm 6 SMD,P=1mm Wire To Board / Wire To Wire Connector ROHS | Custom | C145963 | BOOMELE | - | C145963 | - | 1 | 100 | 108 | LCSC (https://www.lcsc.com/product-detail/Wire-To-Board-Wire-To-Wire-Connector_BOOMELE-Boom-Precision-Elec-C145963_C145963.html) | $0.0680 | $7.3440
16 | Header | J9 | CONN HEADER VERT 2POS 2.54MM | HDR1X2_ | ~~61300211121~~ | Wurth Electronics | B-2100S02P-A110 | C124375 | - | 1 | 100 | 120 | LCSC (https://www.lcsc.com/product-detail/span-style-background-color-ff0-Pin-span-Headers_Ckmtw-Shenzhen-Cankemeng-B-2100S02P-A110_C124375.html) | $0.0220 | $2.6400
17 | INductor | L1 | 5.15A 1uH ±30% SMD Power Inductors ROHS | Custom | MPIT6045-1R0N-LF | microgate | - | C486570 | 1uH | 1 | 100 | 105 | LCSC (https://www.lcsc.com/product-detail/Power-Inductors_microgate-MPIT6045-1R0N-LF_C486570.html) | $0.0593 | $6.2265
18 | Inductor | L2, L3 | FIXED IND 33UH 500MA 275MOHM SMD | Custom | VLCF5024T-330MR50-2 | TDK | - | C2046704 | 33uH | 2 | 200 | 202 | LCSC (https://www.lcsc.com/product-detail/Inductors-SMD_TDK-VLCF5024T-330MR50-2_C2046704.html) | $0.3246 | $65.5692
19 | LED | LED2 | 0603 Light Emitting Diodes (LED) ROHS | LED-0603 | NCD0603R3 | Foshan NationStar Optoelectronics | - | C3151730 | - | 1 | 100 | 120 | LCSC (https://www.lcsc.com/product-detail/Light-Emitting-Diodes-LED_Foshan-NationStar-Optoelectronics-NCD0603R3_C3151730.html) | $0.0208 | $2.4960
20 | RGB LED | LED3, LED4, LED5 | SMD5050 Light Emitting Diodes (LED) ROHS | Custom | WS2812B-XF02/W | Worldsemi | - | C4154882 | - | 3 | 300 | 310 | LCSC (https://www.lcsc.com/product-detail/Light-Emitting-Diodes-LED_Worldsemi-WS2812B-XF02-W_C4154882.html) | $0.0444 | $13.7640
21 | Mosfet | Q1 | 30V 4.1A 60mΩ@10V,4.1A 350mW 3V@250uA P Channel SOT-23 MOSFETs ROHS | SOT-23 | AO3407 | Guangdong Hottech | - | C181093 | - | 1 | 100 | 120 | LCSC (https://www.lcsc.com/product-detail/MOSFETs_Guangdong-Hottech-AO3407_C181093.html) | $0.0325 | $3.9000
22 | Mosfet | Q2, Q3 | 40V 100mW 100@10mA,1V 200mA 300MHz 300mV@50mA,5mA NPN -55℃~+150℃@(Tj) SOT-723 Bipolar Transistors - BJT ROHS | SOT-723 | MMBT3904M | TECH PUBLIC | - | C2923360 | - | 2 | 200 | 220 | LCSC (https://www.lcsc.com/product-detail/Bipolar-Transistors-BJT_TECH-PUBLIC-MMBT3904M_C2923360.html) | $0.0271 | $5.9620
23 | Mosfet | Q6 | N-CHANNEL 20-V (D-S) MOSFET | Sot-23 | SI2302CDS | TECH PUBLIC | - | C5310968 | - | 1 | 100 | 120 | LCSC (https://www.lcsc.com/product-detail/MOSFETs_TECH-PUBLIC-SI2302CDS_C5310968.html) | $0.0341 | $4.0920
24 | Resistor | R1, R2 | RES 5.1K OHM 1% 1/10W 0603 | Res-0603 | RC0603FR-075K1L | Yageo | - | C105580 | 5.1K | 2 | 200 | 300 | LCSC (https://www.lcsc.com/product-detail/Chip-Resistor-Surface-Mount_YAGEO-RC0603FR-075K1L_C105580.html) | $0.0013 | $0.3900
25 | Resistor | R4 | RES SMD 330R 100 mW 0603 | Res-0603 | RC0603JR-07330RL | Yageo | - | C105879 | 330R | 1 | 100 | 200 | LCSC (https://www.lcsc.com/product-detail/Chip-Resistor-Surface-Mount_YAGEO-RC0603JR-07330RL_C105879.html) | $0.0011 | $0.2200
26 | Resistor | R5 | Thick Film Resistors 75V 1.2kΩ 0603 Chip Resistor - Surface Mount ROHS | Res-0603 | 0603WAF1201T5E | UNI-ROYAL | - | C22765 | 1.2K | 1 | 100 | 200 | LCSC (https://www.lcsc.com/product-detail/Chip-Resistor-Surface-Mount_UNI-ROYAL-Uniroyal-Elec-0603WAF1201T5E_C22765.html) | $0.0011 | $0.2200
27 | Resistor | R6, R18, R19, R20, R21, R22 | RES SMD 10K Ohm 1% 1/10W 0603 | Res-0603 | RC0603FR-0710KL | Yageo | - | C98220 | 10K | 6 | 600 | 700 | LCSC (https://www.lcsc.com/product-detail/Chip-Resistor-Surface-Mount_YAGEO-RC0603FR-0710KL_C98220.html) | $0.0010 | $0.7000
28 | Resistor | R7 | ±1% 732kΩ 0402 Chip Resistor - Surface Mount ROHS | Res-0402 | FRC0402F7323TS | FOJAN | - | C5159692 | 732K | 1 | 100 | 200 | LCSC (https://www.lcsc.com/product-detail/Chip-Resistor-Surface-Mount_FOJAN-FRC0402F7323TS_C5159692.html) | $0.0004 | $0.0800
29 | Resistor | R8, R66, R67 | RES SMD 100K OHM 0.1% 1/10W 0603 | Res-0603 | RT0603BRD07100KL | Yageo | - | C122538 | 100K | 3 | 300 | 320 | LCSC (https://www.lcsc.com/product-detail/Chip-Resistor-Surface-Mount_YAGEO-RT0603BRD07100KL_C122538.html) | $0.0168 | $5.3760
30 | Resistor | R9, R12, R54 | RES 47K OHM 5% 1/10W 0603 | Res-0603 | RC0603JR-0747KL | Yageo | - | C127447 | 47K | 3 | 300 | 400 | LCSC (https://www.lcsc.com/product-detail/Chip-Resistor-Surface-Mount_YAGEO-RC0603JR-0747KL_C127447.html) | $0.0011 | $0.4400
31 | Resistor | R10, R11, R56 | RES SMD 4.7K OHM 5% 1/10W 0603 | Res-0603 | RC0603JR-074K7L | Yageo | - | C105428 | 4.7K | 3 | 300 | 400 | LCSC (https://www.lcsc.com/product-detail/Chip-Resistor-Surface-Mount_YAGEO-RC0603JR-074K7L_C105428.html) | $0.0011 | $0.4400
32 | Resistor | R23, R24, R25, R33 | RES SMD 68 OHM 0.1% 1/16W 0402 | Res-0402 | ~~ERA-2AEB680X~~ | Panasonic | RT0402BRD0768RL | C445573 | 68R | 4 | 400 | 420 | LCSC (https://www.lcsc.com/product-detail/Chip-span-style-background-color-ff0-Resistor-span-Surface-Mount_YAGEO-RT0402BRD0768RL_C852891.html) | $0.0204 | $8.5680
33 | Resistor | R26, R27 | RES 10K OHM 1% 1/16W 0402 | Res-0402 | RC0402FR-0710KL | Yageo | - | C60490 | 10K | 2 | 200 | 300 | LCSC (https://www.lcsc.com/product-detail/Chip-Resistor-Surface-Mount_YAGEO-RC0402FR-0710KL_C60490.html) | $0.0006 | $0.1800
34 | Resistor | R28, R55 | RES SMD 1K OHM 1% 1/10W 0603 | Res-0603 | RC0603FR-071KL | Yageo | - | C22548 | 1K | 2 | 200 | 300 | LCSC (https://www.lcsc.com/product-detail/Chip-Resistor-Surface-Mount_YAGEO-RC0603FR-071KL_C22548.html) | $0.0010 | $0.3000
35 | Resistor | R30, R32, R35, R39 | RES SMD 0R, 1%, 0.1W, 0603 | Res-0603 | ~~RC0603FR-070RL~~ | Yageo | 0603WAF0000T5E | C21189 | 0R | 4 | 400 | 500 | LCSC (https://www.lcsc.com/product-detail/Chip-Resistor-Surface-Mount_UNI-ROYAL-Uniroyal-Elec-0603WAF0000T5E_C21189.html) | $0.0011 | $0.5500
36 | Resistor | R65, R69 | RES SMD 1M OHM 1% 1/10W 0603 | Res-0603 | RC0603FR-071ML | Yageo |  | C105578 | 1M | 2 | 200 | 200 | LCSC (https://www.lcsc.com/product-detail/Chip-Resistor-Surface-Mount_YAGEO-RC0603FR-071ML_C105578.html) | $0.0012 | $0.2400
37 | Switch | SW1 | No NO 50mA 4.5mm 100000 260gf 12V -30℃~+85℃ 4.5mm 4.3mm Black Round Button Brick nogging SPST SMD Tactile Switches ROHS | Custom | TS-1109S-C-B | XKB Connectivity | - | C381037 | - | 1 | 100 | 120 | LCSC (https://www.lcsc.com/product-detail/Tactile-Switches_XKB-Connectivity-TS-1109S-C-B_C381037.html) | $0.0217 | $2.6040
38 | Tactile Switch | SW4, SW5, SW6, SW8 | SWITCH TACTILE SPST-NO 0.05A 12V | Custom | TL1260GQRBLK | E-Switch | - | - | - | 4 | 400 | 402 | Chipmall (https://www.chipsmall.com/Products/TL1260GQRBLK_17235276.html) | $2.0342 | $817.7605
39 | Switch | SW7 | No NO 50mA 4.5mm 100000 160gf 12V -30℃~+85℃ 4.5mm 8mm Black Round Button Brick nogging SPST SMD Tactile Switches ROHS | TS-1109S-B-J_ | TS-1109S-B-J | XKB Connectivity | - | C480323 | - | 1 | 100 | 110 | LCSC (https://www.lcsc.com/product-detail/Tactile-Switches_XKB-Connectivity-TS-1109S-B-J_C480323.html) | $0.0326 | $3.5860
40 | Mosfet | U1 | ESOP-8 Battery Management ICs ROHS | ESOP-8 | TP4056-42-ESOP8 | TOPPOWER | - | C16581 | - | 1 | 100 | 105 | LCSC (https://www.lcsc.com/product-detail/Battery-Management-ICs_TOPPOWER-Nanjing-Extension-Microelectronics-TP4056-42-ESOP8_C16581.html) | $0.1428 | $14.9940
41 | IC | U2 | OR Controller N+1 ORing Controller N-Channel 2:1 SOT-583 | SOT-583 | LM66200DRLR | Texas Instruments | - | C3235556 | - | 1 | 100 | 101 | LCSC (https://www.lcsc.com/product-detail/Power-Distribution-Switches_Texas-Instruments-LM66200DRLR_C3235556.html) | $0.2657 | $26.8357
42 | IC | U3 | 8-A boost converter with 0.5-V ultra-low input voltage 7-VQFN-HR -40 to 125 | 7-VQFN-HR (2x2) | TPS61022RWUR | Texas Instruments | - | C915088 | - | 1 | 100 | 101 | LCSC (https://www.lcsc.com/product-detail/DC-DC-Converters_Texas-Instruments-TPS61022RWUR_C915088.html) | $0.3675 | $37.1175
43 | Module | U4 | RF TXRX MODULE BT PCB TRACE SMD | 38-SMD Module | ESP32-WROOM-32E-N8R2 | Espressif Systems | - | C5361945 | - | 1 | 100 | 101 | LCSC (https://www.lcsc.com/product-detail/WiFi-Modules_Espressif-Systems-ESP32-WROOM-32E-N8R2_C5361945.html) | $3.3075 | $334.0575
44 | IC | U7 | SPX3819 Series 3.3 V 500 mA Fixed Output SMT LDO Regulator - SOT-23-5 | SOT-23-5 | SPX3819M5-L-3-3/TR | MaxLinear | - | C9055 | - | 1 | 100 | 102 | LCSC (https://www.lcsc.com/product-detail/Linear-Voltage-Regulators-LDO_MaxLinear-SPX3819M5-L-3-3-TR_C9055.html) | $0.0869 | $8.8638
45 | IC | U8 | IC CNTRLR ON/OFF W/DEB TSOT23-6 | TSOT-23-6 | MAX16054AZT+T | Maxim | - | C79401 | - | 1 | 100 | 101 | LCSC (https://www.lcsc.com/product-detail/Interface-Specialized_Analog-Devices-MAX16054AZT-T_C79401.html) | $0.7946 | $80.2546
46 | IC | U16 | Audio Amplifier, 1 Func, PQCC16 | TQFN-16-EP(3x3) | MAX98357AETE+T | Maxim | - | C910544 | - | 1 | 100 | 101 | LCSC (https://www.lcsc.com/product-detail/Audio-Power-OpAmps_Analog-Devices-Inc-Maxim-Integrated-MAX98357AETE-T_C910544.html) | $0.7191 | $72.6291
47 | Speaker | Peripheral | Speakers ROHS | - | FS40DS0430-H18.8 | - | - | C969979 | - | 1 | 100 | 101 | LCSC (https://www.lcsc.com/product-detail/Speakers_FUET-FS40DS0430-H18-8_C969979.html) | $1.3125 | $132.5625
48 | Battery | Peripheral | 803450 3.7V 1500mAh Lithium Polymer Rechargeable Battery For MP3 GPS Massager Camera Power Bank Laptop Speaker Lipo Li ion Cell | - | - | - | - | - | - | 1 | 100 | 100 | Aliexpress (https://vi.aliexpress.com/item/1005006415551699.html) | $3.0800 | $308.0000
49 | Charger | Peripheral | Universal 5V 1A 2A Type C USB Charger Mobile Phone Wall Travel Power Adapter Charger EU/US Plug For Huawei Xiaomi iPhone Samsung (2A Rating Selected) | - | - | - | - | - | - | 1 | 100 | 1 | Aliexpress (https://vi.aliexpress.com/item/1005005257036835.html) | $0.6600 | $0.6600
50 | Screw | Peripheral | M2 Thread Length 16mm/ Head Dia 4mm | - | M2 (16mm) | - | - | - | - | 3 | 300 | 350 | Aliexpress (https://vi.aliexpress.com/item/32810852732.html?pdp_npi=4) | $0.0254 | $8.8900
51 |  |  | M3 Thread Length 20mm/ Head Dia 5.6mm | - | M3 (20mm) | - | - | - | - | 2 | 200 | 250 | Aliexpress (https://vi.aliexpress.com/item/32810852732.html?pdp_npi=4) | $0.0368 | $9.2000
52 |  |  | M Thread Length 4mm/ Head Dia 5.6mm | - | M3 (4mm) | - | - | - | - | 4 | 400 | 450 | Aliexpress (https://vi.aliexpress.com/item/32810852732.html?pdp_npi=4) | $0.0144 | $6.4800
 |  |  |  |  |  |  |  |  |  |  |  | Total Component Cost |  |  | $2083.76
 |  |  |  |  |  |  |  |  |  |  |  | Single Board Cost |  |  | $20.84

Sheet: 500 Boards
 |  | Component list |  | Bill of Materials for Project [IoT-Speaker v1.3]
 |  | Source Data From: |  | IoT-Speaker v1.3
 |  | Project: |  | IoT-Speaker v1.3
 |  | Variant: |  | None
# | Item Type | Designator | Description | Footprint | Manufacturer Part Number | Manufacturer | Alternate Part Number | LCSC Part Number | Value | Quantity | Quantity (500 Boards) | MOQ (500 Boards) | Links | Unit Cost (500 Boards) | Total Cost (500 Boards) | Remarks | Reviewer Remarks
1 | Capacitor | C1, C5, C6, C13, C16, C103 | CAP CER 10UF 25V X5R 0805 | Cap-0805 | CC0805KKX5R8BB106 | Yageo | - | C89831 | 10uF | 6 | 3000 | 3020 | LCSC (https://www.lcsc.com/product-detail/Multilayer-Ceramic-Capacitors-MLCC-SMD-SMT_YAGEO-CC0805KKX5R8BB106_C89831.html) | $0.0214 | $64.6280
2 | Capacitor | C2, C3, C7, C9, C15, C17, C18, C19, C20, C21, C22, C24, C78, C83 | CAP CER 0.1UF 25V X5R 0402 | Cap-0402 | CC0402KRX5R8BB104 | Yageo | - | C106256 | 100nF | 14 | 7000 | 7100 | LCSC (https://www.lcsc.com/product-detail/Multilayer-Ceramic-Capacitors-MLCC-SMD-SMT_YAGEO-CC0402KRX5R8BB104_C106256.html) | $0.0013 | $9.2300
3 | Capacitor | C4, C12, C76 | CAP CER 10000PF 50V C0G/NPO 0603 | Cap-0603 | CC0603JRNPO9BN103 | Yageo | - | C389113 | 10nF | 3 | 1500 | 1550 | LCSC (https://www.lcsc.com/product-detail/Multilayer-Ceramic-Capacitors-MLCC-SMD-SMT_YAGEO-CC0603JRNPO9BN103_C389113.html) | $0.0124 | $19.2200
4 | Capacitor | C10, C11 | CAP CER 220PF 50V C0G/NPO 0402 | Cap-0402 | CC0402JRNPO9BN221 | Yageo | - | C107001 | 220pF | 2 | 1000 | 1100 | LCSC (https://www.lcsc.com/product-detail/Multilayer-Ceramic-Capacitors-MLCC-SMD-SMT_YAGEO-CC0402JRNPO9BN221_C107001.html) | $0.0018 | $1.9800
5 | Capacitor | C14, C74, C75, C102 | CAP CER 1UF 25V X5R 0603 | Cap-0603 | CC0603KRX5R8BB105 | Yageo | - | C14664 | 1uF | 4 | 2000 | 2100 | LCSC (https://www.lcsc.com/product-detail/Multilayer-Ceramic-Capacitors-MLCC-SMD-SMT_YAGEO-CC0603KRX5R8BB105_C14664.html) | $0.0048 | $10.0800
6 | Capacitor | C23, C25, C26, C77 | CAP CER 22UF 10V X5R 0603 | Cap-0603 | CC0603MRX5R6BB226 | Yageo | - | C109447 | 22uF | 4 | 2000 | 2010 | LCSC (https://www.lcsc.com/product-detail/Multilayer-Ceramic-Capacitors-MLCC-SMD-SMT_YAGEO-CC0603MRX5R6BB226_C109447.html) | $0.0382 | $76.7820
7 | Capacitor | C79 | CAP CER 4700PF 1KV X7R 1206 | Cap-1206 | CC1206KKX7RCBB472 | Yageo | - | C107198 | 4.7nF | 1 | 500 | 550 | LCSC (https://www.lcsc.com/product-detail/Multilayer-Ceramic-Capacitors-MLCC-SMD-SMT_YAGEO-CC1206KKX7RCBB472_C107198.html) | $0.0157 | $8.6350
8 | Diode | D1 | TVS DIODE 5VWM 6.3VC DSN0603-2 | DSN0603-2 | PESD5V0H1BSFYL | Nexperia | - | C477989 | - | 1 | 500 | 510 | LCSC (https://www.lcsc.com/product-detail/ESD-Protection-Devices_Nexperia-PESD5V0H1BSF_C477989.html) | $0.0241 | $12.2910
9 | Diode | D2 | DIODE ZENER 3.3V 200MW SOD323F | SOD323F | MM3Z3V3B | ON Semiconductor / Fairchild | - | C2978865 | - | 1 | 500 | 510 | LCSC (https://www.lcsc.com/product-detail/Zener-Diodes_EIC-Semicon-MM3Z3V3B_C2978865.html) | $0.0282 | $14.3820
10 | Fuse | F1 | 6V 2A 50A 1W -40℃~+85℃ 4A 4mΩ 5s 45mΩ 0805 Resettable Fuses ROHS | Fuse-0805 | BSMD0805L-200 | BHFUSE | - | C2757931 | - | 1 | 500 | 505 | LCSC (https://www.lcsc.com/product-detail/Resettable-Fuses_BHFUSE-BSMD0805L-200_C2757931.html) | $0.0608 | $30.7040
11 | Ferrite Bead | FB1, FB2, FB3 | FERRITE BEAD 30 OHM 0603 1LN / Ferrite Beads Multi-Layer 30Ohm 100MHz 1A 0.05Ohm DCR 0603 T/R | IND-0603 (1608 Metric) | BLM18PG300SN1D | Murata | - | C17305 | - | 3 | 1500 | 1600 | LCSC (https://www.lcsc.com/product-detail/Ferrite-Beads_Murata-Electronics-BLM18PG300SN1D_C17305.html) | $0.0058 | $9.2800
12 | Ferrite Bead | FB7 | FERRITE BEAD 120 OHM 1206 1LN | IND-1206 | BLM31PG121SN1L | Murata | - | C85841 | 100MHz | 1 | 500 | 510 | LCSC (https://www.lcsc.com/product-detail/Ferrite-Beads_Murata-Electronics-BLM31PG121SN1L_C85841.html) | $0.0493 | $25.1430
13 | JST Connector | J1 | Conn Shrouded Header (4 Sides) HDR 2 POS 2.5mm Solder ST Thru-Hole Box | Custom | B2B-XH-A(LF)(SN) | JST | - | C158012 | - | 1 | 500 | 520 | LCSC (https://www.lcsc.com/product-detail/Wire-To-Board-Wire-To-Wire-Connector_JST-Sales-America-B2B-XH-A-LF-SN_C158012.html) | $0.0257 | $13.3640
14 | USB Connector | J2 | 250mA 1 16 Female Type-C SMD USB Connectors ROHS | Custom | TYPE-C-31-M-12 | Korean Hroparts Elec | - | C165948 | - | 1 | 500 | 505 | LCSC (https://www.lcsc.com/product-detail/USB-Connectors_Korean-Hroparts-Elec-TYPE-C-31-M-12_C165948.html) | $0.1120 | $56.5600
15 | Connector | J3 | 1x6P SH 1 1mm 6 SMD,P=1mm Wire To Board / Wire To Wire Connector ROHS | Custom | C145963 | BOOMELE | - | C145963 | - | 1 | 500 | 504 | LCSC (https://www.lcsc.com/product-detail/Wire-To-Board-Wire-To-Wire-Connector_BOOMELE-Boom-Precision-Elec-C145963_C145963.html) | $0.0473 | $23.8392
16 | Header | J9 | CONN HEADER VERT 2POS 2.54MM | HDR1X2_ | ~~61300211121~~ | Wurth Electronics | B-2100S02P-A110 | C124375 | - | 1 | 500 | 520 | LCSC (https://www.lcsc.com/product-detail/span-style-background-color-ff0-Pin-span-Headers_Ckmtw-Shenzhen-Cankemeng-B-2100S02P-A110_C124375.html) | $0.0179 | $9.3080
17 | INductor | L1 | 5.15A 1uH ±30% SMD Power Inductors ROHS | Custom | MPIT6045-1R0N-LF | microgate | - | C486570 | 1uH | 1 | 500 | 505 | LCSC (https://www.lcsc.com/product-detail/Power-Inductors_microgate-MPIT6045-1R0N-LF_C486570.html) | $0.0526 | $26.5630
18 | Inductor | L2, L3 | FIXED IND 33UH 500MA 275MOHM SMD | Custom | VLCF5024T-330MR50-2 | TDK | - | C2046704 | 33uH | 2 | 1000 | 1002 | LCSC (https://www.lcsc.com/product-detail/Inductors-SMD_TDK-VLCF5024T-330MR50-2_C2046704.html) | $0.2880 | $288.5760
19 | LED | LED2 | 0603 Light Emitting Diodes (LED) ROHS | LED-0603 | NCD0603R3 | Foshan NationStar Optoelectronics | - | C3151730 | - | 1 | 500 | 520 | LCSC (https://www.lcsc.com/product-detail/Light-Emitting-Diodes-LED_Foshan-NationStar-Optoelectronics-NCD0603R3_C3151730.html) | $0.0171 | $8.8920
20 | RGB LED | LED3, LED4, LED5 | SMD5050 Light Emitting Diodes (LED) ROHS | Custom | WS2812B-XF02/W | Worldsemi | - | C4154882 | - | 3 | 1500 | 1510 | LCSC (https://www.lcsc.com/product-detail/Light-Emitting-Diodes-LED_Worldsemi-WS2812B-XF02-W_C4154882.html) | $0.0401 | $60.5510
21 | Mosfet | Q1 | 30V 4.1A 60mΩ@10V,4.1A 350mW 3V@250uA P Channel SOT-23 MOSFETs ROHS | SOT-23 | AO3407 | Guangdong Hottech | - | C181093 | - | 1 | 500 | 520 | LCSC (https://www.lcsc.com/product-detail/MOSFETs_Guangdong-Hottech-AO3407_C181093.html) | $0.0259 | $13.4680
22 | Mosfet | Q2, Q3 | 40V 100mW 100@10mA,1V 200mA 300MHz 300mV@50mA,5mA NPN -55℃~+150℃@(Tj) SOT-723 Bipolar Transistors - BJT ROHS | SOT-723 | MMBT3904M | TECH PUBLIC | - | C2923360 | - | 2 | 1000 | 1020 | LCSC (https://www.lcsc.com/product-detail/Bipolar-Transistors-BJT_TECH-PUBLIC-MMBT3904M_C2923360.html) | $0.0235 | $23.9700
23 | Mosfet | Q6 | N-CHANNEL 20-V (D-S) MOSFET | Sot-23 | SI2302CDS | TECH PUBLIC | - | C5310968 | - | 1 | 500 | 520 | LCSC (https://www.lcsc.com/product-detail/MOSFETs_TECH-PUBLIC-SI2302CDS_C5310968.html) | $0.0277 | $14.4040
24 | Resistor | R1, R2 | RES 5.1K OHM 1% 1/10W 0603 | Res-0603 | RC0603FR-075K1L | Yageo | - | C105580 | 5.1K | 2 | 1000 | 1100 | LCSC (https://www.lcsc.com/product-detail/Chip-Resistor-Surface-Mount_YAGEO-RC0603FR-075K1L_C105580.html) | $0.0010 | $1.1000
25 | Resistor | R4 | RES SMD 330R 100 mW 0603 | Res-0603 | RC0603JR-07330RL | Yageo | - | C105879 | 330R | 1 | 500 | 600 | LCSC (https://www.lcsc.com/product-detail/Chip-Resistor-Surface-Mount_YAGEO-RC0603JR-07330RL_C105879.html) | $0.0011 | $0.6600
26 | Resistor | R5 | Thick Film Resistors 75V 1.2kΩ 0603 Chip Resistor - Surface Mount ROHS | Res-0603 | 0603WAF1201T5E | UNI-ROYAL | - | C22765 | 1.2K | 1 | 500 | 600 | LCSC (https://www.lcsc.com/product-detail/Chip-Resistor-Surface-Mount_UNI-ROYAL-Uniroyal-Elec-0603WAF1201T5E_C22765.html) | $0.0011 | $0.6600
27 | Resistor | R6, R18, R19, R20, R21, R22 | RES SMD 10K Ohm 1% 1/10W 0603 | Res-0603 | RC0603FR-0710KL | Yageo | - | C98220 | 10K | 6 | 3000 | 3100 | LCSC (https://www.lcsc.com/product-detail/Chip-Resistor-Surface-Mount_YAGEO-RC0603FR-0710KL_C98220.html) | $0.0008 | $2.4800
28 | Resistor | R7 | ±1% 732kΩ 0402 Chip Resistor - Surface Mount ROHS | Res-0402 | FRC0402F7323TS | FOJAN | - | C5159692 | 732K | 1 | 500 | 600 | LCSC (https://www.lcsc.com/product-detail/Chip-Resistor-Surface-Mount_FOJAN-FRC0402F7323TS_C5159692.html) | $0.0004 | $0.2400
29 | Resistor | R8, R66, R67 | RES SMD 100K OHM 0.1% 1/10W 0603 | Res-0603 | RT0603BRD07100KL | Yageo | - | C122538 | 100K | 3 | 1500 | 1520 | LCSC (https://www.lcsc.com/product-detail/Chip-Resistor-Surface-Mount_YAGEO-RT0603BRD07100KL_C122538.html) | $0.0149 | $22.6480
30 | Resistor | R9, R12, R54 | RES 47K OHM 5% 1/10W 0603 | Res-0603 | RC0603JR-0747KL | Yageo | - | C127447 | 47K | 3 | 1500 | 1600 | LCSC (https://www.lcsc.com/product-detail/Chip-Resistor-Surface-Mount_YAGEO-RC0603JR-0747KL_C127447.html) | $0.0009 | $1.4400
31 | Resistor | R10, R11, R56 | RES SMD 4.7K OHM 5% 1/10W 0603 | Res-0603 | RC0603JR-074K7L | Yageo | - | C105428 | 4.7K | 3 | 1500 | 1600 | LCSC (https://www.lcsc.com/product-detail/Chip-Resistor-Surface-Mount_YAGEO-RC0603JR-074K7L_C105428.html) | $0.0009 | $1.4400
32 | Resistor | R23, R24, R25, R33 | RES SMD 68 OHM 0.1% 1/16W 0402 | Res-0402 | ~~ERA-2AEB680X~~ | Panasonic | RT0402BRD0768RL | C445573 | 68R | 4 | 2000 | 2020 | LCSC (https://www.lcsc.com/product-detail/Chip-span-style-background-color-ff0-Resistor-span-Surface-Mount_YAGEO-RT0402BRD0768RL_C852891.html) | $0.0162 | $32.7240
33 | Resistor | R26, R27 | RES 10K OHM 1% 1/16W 0402 | Res-0402 | RC0402FR-0710KL | Yageo | - | C60490 | 10K | 2 | 1000 | 1100 | LCSC (https://www.lcsc.com/product-detail/Chip-Resistor-Surface-Mount_YAGEO-RC0402FR-0710KL_C60490.html) | $0.0004 | $0.4400
34 | Resistor | R28, R55 | RES SMD 1K OHM 1% 1/10W 0603 | Res-0603 | RC0603FR-071KL | Yageo | - | C22548 | 1K | 2 | 1000 | 1100 | LCSC (https://www.lcsc.com/product-detail/Chip-Resistor-Surface-Mount_YAGEO-RC0603FR-071KL_C22548.html) | $0.0010 | $1.1000
35 | Resistor | R30, R32, R35, R39 | RES SMD 0R, 1%, 0.1W, 0603 | Res-0603 | ~~RC0603FR-070RL~~ | Yageo | 0603WAF0000T5E | C21189 | 0R | 4 | 2000 | 2100 | LCSC (https://www.lcsc.com/product-detail/Chip-Resistor-Surface-Mount_UNI-ROYAL-Uniroyal-Elec-0603WAF0000T5E_C21189.html) | $0.0009 | $1.8900
36 | Resistor | R65, R69 | RES SMD 1M OHM 1% 1/10W 0603 | Res-0603 | RC0603FR-071ML | Yageo |  | C105578 | 1M | 2 | 1000 | 1100 | LCSC (https://www.lcsc.com/product-detail/Chip-Resistor-Surface-Mount_YAGEO-RC0603FR-071ML_C105578.html) | $0.0012 | $1.3200
37 | Switch | SW1 | No NO 50mA 4.5mm 100000 260gf 12V -30℃~+85℃ 4.5mm 4.3mm Black Round Button Brick nogging SPST SMD Tactile Switches ROHS | Custom | TS-1109S-C-B | XKB Connectivity | - | C381037 | - | 1 | 500 | 520 | LCSC (https://www.lcsc.com/product-detail/Tactile-Switches_XKB-Connectivity-TS-1109S-C-B_C381037.html) | $0.0174 | $9.0480
38 | Tactile Switch | SW4, SW5, SW6, SW8 | SWITCH TACTILE SPST-NO 0.05A 12V | Custom | TL1260GQRBLK | E-Switch | - | - | - | 4 | 2000 | 2002 | Chipmall (https://www.chipsmall.com/Products/TL1260GQRBLK_17235276.html) | $1.7689 | $3541.3378
39 | Switch | SW7 | No NO 50mA 4.5mm 100000 160gf 12V -30℃~+85℃ 4.5mm 8mm Black Round Button Brick nogging SPST SMD Tactile Switches ROHS | TS-1109S-B-J_ | TS-1109S-B-J | XKB Connectivity | - | C480323 | - | 1 | 500 | 510 | LCSC (https://www.lcsc.com/product-detail/Tactile-Switches_XKB-Connectivity-TS-1109S-B-J_C480323.html) | $0.0288 | $14.6880
40 | Mosfet | U1 | ESOP-8 Battery Management ICs ROHS | ESOP-8 | TP4056-42-ESOP8 | TOPPOWER | - | C16581 | - | 1 | 500 | 505 | LCSC (https://www.lcsc.com/product-detail/Battery-Management-ICs_TOPPOWER-Nanjing-Extension-Microelectronics-TP4056-42-ESOP8_C16581.html) | $0.1121 | $56.6105
41 | IC | U2 | OR Controller N+1 ORing Controller N-Channel 2:1 SOT-583 | SOT-583 | LM66200DRLR | Texas Instruments | - | C3235556 | - | 1 | 500 | 501 | LCSC (https://www.lcsc.com/product-detail/Power-Distribution-Switches_Texas-Instruments-LM66200DRLR_C3235556.html) | $0.2244 | $112.4244
42 | IC | U3 | 8-A boost converter with 0.5-V ultra-low input voltage 7-VQFN-HR -40 to 125 | 7-VQFN-HR (2x2) | TPS61022RWUR | Texas Instruments | - | C915088 | - | 1 | 500 | 501 | LCSC (https://www.lcsc.com/product-detail/DC-DC-Converters_Texas-Instruments-TPS61022RWUR_C915088.html) | $0.3373 | $168.9873
43 | Module | U4 | RF TXRX MODULE BT PCB TRACE SMD | 38-SMD Module | ESP32-WROOM-32E-N8R2 | Espressif Systems | - | C5361945 | - | 1 | 500 | 501 | LCSC (https://www.lcsc.com/product-detail/WiFi-Modules_Espressif-Systems-ESP32-WROOM-32E-N8R2_C5361945.html) | $3.3075 | $1657.0575
44 | IC | U7 | SPX3819 Series 3.3 V 500 mA Fixed Output SMT LDO Regulator - SOT-23-5 | SOT-23-5 | SPX3819M5-L-3-3/TR | MaxLinear | - | C9055 | - | 1 | 500 | 502 | LCSC (https://www.lcsc.com/product-detail/Linear-Voltage-Regulators-LDO_MaxLinear-SPX3819M5-L-3-3-TR_C9055.html) | $0.0752 | $37.7504
45 | IC | U8 | IC CNTRLR ON/OFF W/DEB TSOT23-6 | TSOT-23-6 | MAX16054AZT+T | Maxim | - | C79401 | - | 1 | 500 | 501 | LCSC (https://www.lcsc.com/product-detail/Interface-Specialized_Analog-Devices-MAX16054AZT-T_C79401.html) | $0.7369 | $369.1869
46 | IC | U16 | Audio Amplifier, 1 Func, PQCC16 | TQFN-16-EP(3x3) | MAX98357AETE+T | Maxim | - | C910544 | - | 1 | 500 | 501 | LCSC (https://www.lcsc.com/product-detail/Audio-Power-OpAmps_Analog-Devices-Inc-Maxim-Integrated-MAX98357AETE-T_C910544.html) | $0.6841 | $342.7341
47 | Speaker | Peripheral | Speakers ROHS | - | FS40DS0430-H18.8 | - | - | C969979 | - | 1 | 500 | 501 | LCSC (https://www.lcsc.com/product-detail/Speakers_FUET-FS40DS0430-H18-8_C969979.html) | $1.2330 | $617.7330
48 | Battery | Peripheral | 803450 3.7V 1500mAh Lithium Polymer Rechargeable Battery For MP3 GPS Massager Camera Power Bank Laptop Speaker Lipo Li ion Cell | - | - | - | - | - | - | 1 | 500 | 500 | Aliexpress (https://vi.aliexpress.com/item/1005006415551699.html) | $3.0800 | $1540.0000
49 | Charger | Peripheral | Universal 5V 1A 2A Type C USB Charger Mobile Phone Wall Travel Power Adapter Charger EU/US Plug For Huawei Xiaomi iPhone Samsung (2A Rating Selected) | - | - | - | - | - | - | 1 | 500 | 1 | Aliexpress (https://vi.aliexpress.com/item/1005005257036835.html) | $0.6600 | $0.6600
50 | Screw | Peripheral | M2 Thread Length 16mm/ Head Dia 4mm | - | M2 (16mm) | - | - | - | - | 3 | 1500 | 1550 | Aliexpress (https://vi.aliexpress.com/item/32810852732.html?pdp_npi=4) | $0.0254 | $39.3700
51 |  |  | M3 Thread Length 20mm/ Head Dia 5.6mm | - | M3 (20mm) | - | - | - | - | 2 | 1000 | 1050 | Aliexpress (https://vi.aliexpress.com/item/32810852732.html?pdp_npi=4) | $0.0368 | $38.6400
52 |  |  | M Thread Length 4mm/ Head Dia 5.6mm | - | M3 (4mm) | - | - | - | - | 4 | 2000 | 2050 | Aliexpress (https://vi.aliexpress.com/item/32810852732.html?pdp_npi=4) | $0.0144 | $29.5200
 |  |  |  |  |  |  |  |  |  |  |  | Total Component Cost |  |  | $9465.74
 |  |  |  |  |  |  |  |  |  |  |  | Single Board Cost |  |  | $18.93

Sheet: 5000 Boards
 |  | Component list |  | Bill of Materials for Project [IoT-Speaker v1.3]
 |  | Source Data From: |  | IoT-Speaker v1.3
 |  | Project: |  | IoT-Speaker v1.3
 |  | Variant: |  | None
# | Item Type | Designator | Description | Footprint | Manufacturer Part Number | Manufacturer | Alternate Part Number | LCSC Part Number | Value | Quantity | Quantity (5000 Boards) | MOQ (5000 Boards) | Links | Unit Cost (5000 Boards) | Total Cost (5000 Boards) | Remarks | Reviewer Remarks
1 | Capacitor | C1, C5, C6, C13, C16, C103 | CAP CER 10UF 25V X5R 0805 | Cap-0805 | CC0805KKX5R8BB106 | Yageo | - | C89831 | 10uF | 6 | 30000 | 30020 | LCSC (https://www.lcsc.com/product-detail/Multilayer-Ceramic-Capacitors-MLCC-SMD-SMT_YAGEO-CC0805KKX5R8BB106_C89831.html) | $0.0187 | $561.3740
2 | Capacitor | C2, C3, C7, C9, C15, C17, C18, C19, C20, C21, C22, C24, C78, C83 | CAP CER 0.1UF 25V X5R 0402 | Cap-0402 | CC0402KRX5R8BB104 | Yageo | - | C106256 | 100nF | 14 | 70000 | 70100 | LCSC (https://www.lcsc.com/product-detail/Multilayer-Ceramic-Capacitors-MLCC-SMD-SMT_YAGEO-CC0402KRX5R8BB104_C106256.html) | $0.0011 | $77.1100
3 | Capacitor | C4, C12, C76 | CAP CER 10000PF 50V C0G/NPO 0603 | Cap-0603 | CC0603JRNPO9BN103 | Yageo | - | C389113 | 10nF | 3 | 15000 | 15050 | LCSC (https://www.lcsc.com/product-detail/Multilayer-Ceramic-Capacitors-MLCC-SMD-SMT_YAGEO-CC0603JRNPO9BN103_C389113.html) | $0.0107 | $161.0350
4 | Capacitor | C10, C11 | CAP CER 220PF 50V C0G/NPO 0402 | Cap-0402 | CC0402JRNPO9BN221 | Yageo | - | C107001 | 220pF | 2 | 10000 | 10100 | LCSC (https://www.lcsc.com/product-detail/Multilayer-Ceramic-Capacitors-MLCC-SMD-SMT_YAGEO-CC0402JRNPO9BN221_C107001.html) | $0.0014 | $14.1400
5 | Capacitor | C14, C74, C75, C102 | CAP CER 1UF 25V X5R 0603 | Cap-0603 | CC0603KRX5R8BB105 | Yageo | - | C14664 | 1uF | 4 | 20000 | 20100 | LCSC (https://www.lcsc.com/product-detail/Multilayer-Ceramic-Capacitors-MLCC-SMD-SMT_YAGEO-CC0603KRX5R8BB105_C14664.html) | $0.0035 | $70.3500
6 | Capacitor | C23, C25, C26, C77 | CAP CER 22UF 10V X5R 0603 | Cap-0603 | CC0603MRX5R6BB226 | Yageo | - | C109447 | 22uF | 4 | 20000 | 20010 | LCSC (https://www.lcsc.com/product-detail/Multilayer-Ceramic-Capacitors-MLCC-SMD-SMT_YAGEO-CC0603MRX5R6BB226_C109447.html) | $0.0311 | $622.3110
7 | Capacitor | C79 | CAP CER 4700PF 1KV X7R 1206 | Cap-1206 | CC1206KKX7RCBB472 | Yageo | - | C107198 | 4.7nF | 1 | 5000 | 5100 | LCSC (https://www.lcsc.com/product-detail/Multilayer-Ceramic-Capacitors-MLCC-SMD-SMT_YAGEO-CC1206KKX7RCBB472_C107198.html) | $0.0138 | $70.3800
8 | Diode | D1 | TVS DIODE 5VWM 6.3VC DSN0603-2 | DSN0603-2 | PESD5V0H1BSFYL | Nexperia | - | C477989 | - | 1 | 5000 | 5010 | LCSC (https://www.lcsc.com/product-detail/ESD-Protection-Devices_Nexperia-PESD5V0H1BSF_C477989.html) | $0.0186 | $93.1860
9 | Diode | D2 | DIODE ZENER 3.3V 200MW SOD323F | SOD323F | MM3Z3V3B | ON Semiconductor / Fairchild | - | C2978865 | - | 1 | 5000 | 5010 | LCSC (https://www.lcsc.com/product-detail/Zener-Diodes_EIC-Semicon-MM3Z3V3B_C2978865.html) | $0.0252 | $126.2520
10 | Fuse | F1 | 6V 2A 50A 1W -40℃~+85℃ 4A 4mΩ 5s 45mΩ 0805 Resettable Fuses ROHS | Fuse-0805 | BSMD0805L-200 | BHFUSE | - | C2757931 | - | 1 | 5000 | 5005 | LCSC (https://www.lcsc.com/product-detail/Resettable-Fuses_BHFUSE-BSMD0805L-200_C2757931.html) | $0.0489 | $244.7445
11 | Ferrite Bead | FB1, FB2, FB3 | FERRITE BEAD 30 OHM 0603 1LN / Ferrite Beads Multi-Layer 30Ohm 100MHz 1A 0.05Ohm DCR 0603 T/R | IND-0603 (1608 Metric) | BLM18PG300SN1D | Murata | - | C17305 | - | 3 | 15000 | 15100 | LCSC (https://www.lcsc.com/product-detail/Ferrite-Beads_Murata-Electronics-BLM18PG300SN1D_C17305.html) | $0.0046 | $69.4600
12 | Ferrite Bead | FB7 | FERRITE BEAD 120 OHM 1206 1LN | IND-1206 | BLM31PG121SN1L | Murata | - | C85841 | 100MHz | 1 | 5000 | 5010 | LCSC (https://www.lcsc.com/product-detail/Ferrite-Beads_Murata-Electronics-BLM31PG121SN1L_C85841.html) | $0.0449 | $224.9490
13 | JST Connector | J1 | Conn Shrouded Header (4 Sides) HDR 2 POS 2.5mm Solder ST Thru-Hole Box | Custom | B2B-XH-A(LF)(SN) | JST | - | C158012 | - | 1 | 5000 | 5020 | LCSC (https://www.lcsc.com/product-detail/Wire-To-Board-Wire-To-Wire-Connector_JST-Sales-America-B2B-XH-A-LF-SN_C158012.html) | $0.0178 | $89.3560
14 | USB Connector | J2 | 250mA 1 16 Female Type-C SMD USB Connectors ROHS | Custom | TYPE-C-31-M-12 | Korean Hroparts Elec | - | C165948 | - | 1 | 5000 | 5005 | LCSC (https://www.lcsc.com/product-detail/USB-Connectors_Korean-Hroparts-Elec-TYPE-C-31-M-12_C165948.html) | $0.0913 | $456.9565
15 | Connector | J3 | 1x6P SH 1 1mm 6 SMD,P=1mm Wire To Board / Wire To Wire Connector ROHS | Custom | C145963 | BOOMELE | - | C145963 | - | 1 | 5000 | 5004 | LCSC (https://www.lcsc.com/product-detail/Wire-To-Board-Wire-To-Wire-Connector_BOOMELE-Boom-Precision-Elec-C145963_C145963.html) | $0.0426 | $213.1704
16 | Header | J9 | CONN HEADER VERT 2POS 2.54MM | HDR1X2_ | ~~61300211121~~ | Wurth Electronics | B-2100S02P-A110 | C124375 | - | 1 | 5000 | 5020 | LCSC (https://www.lcsc.com/product-detail/span-style-background-color-ff0-Pin-span-Headers_Ckmtw-Shenzhen-Cankemeng-B-2100S02P-A110_C124375.html) | $0.0142 | $71.2840
17 | INductor | L1 | 5.15A 1uH ±30% SMD Power Inductors ROHS | Custom | MPIT6045-1R0N-LF | microgate | - | C486570 | 1uH | 1 | 5000 | 5005 | LCSC (https://www.lcsc.com/product-detail/Power-Inductors_microgate-MPIT6045-1R0N-LF_C486570.html) | $0.0416 | $208.2080
18 | Inductor | L2, L3 | FIXED IND 33UH 500MA 275MOHM SMD | Custom | VLCF5024T-330MR50-2 | TDK | - | C2046704 | 33uH | 2 | 10000 | 10002 | LCSC (https://www.lcsc.com/product-detail/Inductors-SMD_TDK-VLCF5024T-330MR50-2_C2046704.html) | $0.2880 | $2880.5760
19 | LED | LED2 | 0603 Light Emitting Diodes (LED) ROHS | LED-0603 | NCD0603R3 | Foshan NationStar Optoelectronics | - | C3151730 | - | 1 | 5000 | 5020 | LCSC (https://www.lcsc.com/product-detail/Light-Emitting-Diodes-LED_Foshan-NationStar-Optoelectronics-NCD0603R3_C3151730.html) | $0.0131 | $65.7620
20 | RGB LED | LED3, LED4, LED5 | SMD5050 Light Emitting Diodes (LED) ROHS | Custom | WS2812B-XF02/W | Worldsemi | - | C4154882 | - | 3 | 15000 | 15010 | LCSC (https://www.lcsc.com/product-detail/Light-Emitting-Diodes-LED_Worldsemi-WS2812B-XF02-W_C4154882.html) | $0.0349 | $523.8490
21 | Mosfet | Q1 | 30V 4.1A 60mΩ@10V,4.1A 350mW 3V@250uA P Channel SOT-23 MOSFETs ROHS | SOT-23 | AO3407 | Guangdong Hottech | - | C181093 | - | 1 | 5000 | 5020 | LCSC (https://www.lcsc.com/product-detail/MOSFETs_Guangdong-Hottech-AO3407_C181093.html) | $0.0196 | $98.3920
22 | Mosfet | Q2, Q3 | 40V 100mW 100@10mA,1V 200mA 300MHz 300mV@50mA,5mA NPN -55℃~+150℃@(Tj) SOT-723 Bipolar Transistors - BJT ROHS | SOT-723 | MMBT3904M | TECH PUBLIC | - | C2923360 | - | 2 | 10000 | 10020 | LCSC (https://www.lcsc.com/product-detail/Bipolar-Transistors-BJT_TECH-PUBLIC-MMBT3904M_C2923360.html) | $0.0156 | $156.3120
23 | Mosfet | Q6 | N-CHANNEL 20-V (D-S) MOSFET | Sot-23 | SI2302CDS | TECH PUBLIC | - | C5310968 | - | 1 | 5000 | 5020 | LCSC (https://www.lcsc.com/product-detail/MOSFETs_TECH-PUBLIC-SI2302CDS_C5310968.html) | $0.0189 | $94.8780
24 | Resistor | R1, R2 | RES 5.1K OHM 1% 1/10W 0603 | Res-0603 | RC0603FR-075K1L | Yageo | - | C105580 | 5.1K | 2 | 10000 | 10100 | LCSC (https://www.lcsc.com/product-detail/Chip-Resistor-Surface-Mount_YAGEO-RC0603FR-075K1L_C105580.html) | $0.0008 | $8.0800
25 | Resistor | R4 | RES SMD 330R 100 mW 0603 | Res-0603 | RC0603JR-07330RL | Yageo | - | C105879 | 330R | 1 | 5000 | 5100 | LCSC (https://www.lcsc.com/product-detail/Chip-Resistor-Surface-Mount_YAGEO-RC0603JR-07330RL_C105879.html) | $0.0007 | $3.5700
26 | Resistor | R5 | Thick Film Resistors 75V 1.2kΩ 0603 Chip Resistor - Surface Mount ROHS | Res-0603 | 0603WAF1201T5E | UNI-ROYAL | - | C22765 | 1.2K | 1 | 5000 | 5100 | LCSC (https://www.lcsc.com/product-detail/Chip-Resistor-Surface-Mount_UNI-ROYAL-Uniroyal-Elec-0603WAF1201T5E_C22765.html) | $0.0008 | $4.0800
27 | Resistor | R6, R18, R19, R20, R21, R22 | RES SMD 10K Ohm 1% 1/10W 0603 | Res-0603 | RC0603FR-0710KL | Yageo | - | C98220 | 10K | 6 | 30000 | 30100 | LCSC (https://www.lcsc.com/product-detail/Chip-Resistor-Surface-Mount_YAGEO-RC0603FR-0710KL_C98220.html) | $0.0006 | $18.0600
28 | Resistor | R7 | ±1% 732kΩ 0402 Chip Resistor - Surface Mount ROHS | Res-0402 | FRC0402F7323TS | FOJAN | - | C5159692 | 732K | 1 | 5000 | 5100 | LCSC (https://www.lcsc.com/product-detail/Chip-Resistor-Surface-Mount_FOJAN-FRC0402F7323TS_C5159692.html) | $0.0003 | $1.5300
29 | Resistor | R8, R66, R67 | RES SMD 100K OHM 0.1% 1/10W 0603 | Res-0603 | RT0603BRD07100KL | Yageo | - | C122538 | 100K | 3 | 15000 | 15020 | LCSC (https://www.lcsc.com/product-detail/Chip-Resistor-Surface-Mount_YAGEO-RT0603BRD07100KL_C122538.html) | $0.0117 | $175.7340
30 | Resistor | R9, R12, R54 | RES 47K OHM 5% 1/10W 0603 | Res-0603 | RC0603JR-0747KL | Yageo | - | C127447 | 47K | 3 | 15000 | 15100 | LCSC (https://www.lcsc.com/product-detail/Chip-Resistor-Surface-Mount_YAGEO-RC0603JR-0747KL_C127447.html) | $0.0007 | $10.5700
31 | Resistor | R10, R11, R56 | RES SMD 4.7K OHM 5% 1/10W 0603 | Res-0603 | RC0603JR-074K7L | Yageo | - | C105428 | 4.7K | 3 | 15000 | 15100 | LCSC (https://www.lcsc.com/product-detail/Chip-Resistor-Surface-Mount_YAGEO-RC0603JR-074K7L_C105428.html) | $0.0007 | $10.5700
32 | Resistor | R23, R24, R25, R33 | RES SMD 68 OHM 0.1% 1/16W 0402 | Res-0402 | ~~ERA-2AEB680X~~ | Panasonic | RT0402BRD0768RL | C445573 | 68R | 4 | 20000 | 20020 | LCSC (https://www.lcsc.com/product-detail/Chip-span-style-background-color-ff0-Resistor-span-Surface-Mount_YAGEO-RT0402BRD0768RL_C852891.html) | $0.0135 | $270.2700
33 | Resistor | R26, R27 | RES 10K OHM 1% 1/16W 0402 | Res-0402 | RC0402FR-0710KL | Yageo | - | C60490 | 10K | 2 | 10000 | 10100 | LCSC (https://www.lcsc.com/product-detail/Chip-Resistor-Surface-Mount_YAGEO-RC0402FR-0710KL_C60490.html) | $0.0003 | $3.0300
34 | Resistor | R28, R55 | RES SMD 1K OHM 1% 1/10W 0603 | Res-0603 | RC0603FR-071KL | Yageo | - | C22548 | 1K | 2 | 10000 | 10100 | LCSC (https://www.lcsc.com/product-detail/Chip-Resistor-Surface-Mount_YAGEO-RC0603FR-071KL_C22548.html) | $0.0006 | $6.0600
35 | Resistor | R30, R32, R35, R39 | RES SMD 0R, 1%, 0.1W, 0603 | Res-0603 | ~~RC0603FR-070RL~~ | Yageo | 0603WAF0000T5E | C21189 | 0R | 4 | 20000 | 20100 | LCSC (https://www.lcsc.com/product-detail/Chip-Resistor-Surface-Mount_UNI-ROYAL-Uniroyal-Elec-0603WAF0000T5E_C21189.html) | $0.0006 | $12.0600
36 | Resistor | R65, R69 | RES SMD 1M OHM 1% 1/10W 0603 | Res-0603 | RC0603FR-071ML | Yageo |  | C105578 | 1M | 2 | 10000 | 10100 | LCSC (https://www.lcsc.com/product-detail/Chip-Resistor-Surface-Mount_YAGEO-RC0603FR-071ML_C105578.html) | $0.0009 | $9.0900
37 | Switch | SW1 | No NO 50mA 4.5mm 100000 260gf 12V -30℃~+85℃ 4.5mm 4.3mm Black Round Button Brick nogging SPST SMD Tactile Switches ROHS | Custom | TS-1109S-C-B | XKB Connectivity | - | C381037 | - | 1 | 5000 | 5020 | LCSC (https://www.lcsc.com/product-detail/Tactile-Switches_XKB-Connectivity-TS-1109S-C-B_C381037.html) | $0.0135 | $67.7700
38 | Tactile Switch | SW4, SW5, SW6, SW8 | SWITCH TACTILE SPST-NO 0.05A 12V | Custom | TL1260GQRBLK | E-Switch | - | - | - | 4 | 20000 | 20002 | Chipmall (https://www.chipsmall.com/Products/TL1260GQRBLK_17235276.html) | $1.7689 | $35381.5378
39 | Switch | SW7 | No NO 50mA 4.5mm 100000 160gf 12V -30℃~+85℃ 4.5mm 8mm Black Round Button Brick nogging SPST SMD Tactile Switches ROHS | TS-1109S-B-J_ | TS-1109S-B-J | XKB Connectivity | - | C480323 | - | 1 | 5000 | 5010 | LCSC (https://www.lcsc.com/product-detail/Tactile-Switches_XKB-Connectivity-TS-1109S-B-J_C480323.html) | $0.0232 | $116.2320
40 | Mosfet | U1 | ESOP-8 Battery Management ICs ROHS | ESOP-8 | TP4056-42-ESOP8 | TOPPOWER | - | C16581 | - | 1 | 5000 | 5005 | LCSC (https://www.lcsc.com/product-detail/Battery-Management-ICs_TOPPOWER-Nanjing-Extension-Microelectronics-TP4056-42-ESOP8_C16581.html) | $0.0892 | $446.4460
41 | IC | U2 | OR Controller N+1 ORing Controller N-Channel 2:1 SOT-583 | SOT-583 | LM66200DRLR | Texas Instruments | - | C3235556 | - | 1 | 5000 | 5001 | LCSC (https://www.lcsc.com/product-detail/Power-Distribution-Switches_Texas-Instruments-LM66200DRLR_C3235556.html) | $0.2132 | $1066.2132
42 | IC | U3 | 8-A boost converter with 0.5-V ultra-low input voltage 7-VQFN-HR -40 to 125 | 7-VQFN-HR (2x2) | TPS61022RWUR | Texas Instruments | - | C915088 | - | 1 | 5000 | 5001 | LCSC (https://www.lcsc.com/product-detail/DC-DC-Converters_Texas-Instruments-TPS61022RWUR_C915088.html) | $0.3198 | $1599.3198
43 | Module | U4 | RF TXRX MODULE BT PCB TRACE SMD | 38-SMD Module | ESP32-WROOM-32E-N8R2 | Espressif Systems | - | C5361945 | - | 1 | 5000 | 5001 | LCSC (https://www.lcsc.com/product-detail/WiFi-Modules_Espressif-Systems-ESP32-WROOM-32E-N8R2_C5361945.html) | $3.3075 | $16540.8075
44 | IC | U7 | SPX3819 Series 3.3 V 500 mA Fixed Output SMT LDO Regulator - SOT-23-5 | SOT-23-5 | SPX3819M5-L-3-3/TR | MaxLinear | - | C9055 | - | 1 | 5000 | 5002 | LCSC (https://www.lcsc.com/product-detail/Linear-Voltage-Regulators-LDO_MaxLinear-SPX3819M5-L-3-3-TR_C9055.html) | $0.0701 | $350.6402
45 | IC | U8 | IC CNTRLR ON/OFF W/DEB TSOT23-6 | TSOT-23-6 | MAX16054AZT+T | Maxim | - | C79401 | - | 1 | 5000 | 5001 | LCSC (https://www.lcsc.com/product-detail/Interface-Specialized_Analog-Devices-MAX16054AZT-T_C79401.html) | $0.7118 | $3559.7118
46 | IC | U16 | Audio Amplifier, 1 Func, PQCC16 | TQFN-16-EP(3x3) | MAX98357AETE+T | Maxim | - | C910544 | - | 1 | 5000 | 5001 | LCSC (https://www.lcsc.com/product-detail/Audio-Power-OpAmps_Analog-Devices-Inc-Maxim-Integrated-MAX98357AETE-T_C910544.html) | $0.6682 | $3341.6682
47 | Speaker | Peripheral | Speakers ROHS | - | FS40DS0430-H18.8 | - | - | C969979 | - | 1 | 5000 | 5001 | LCSC (https://www.lcsc.com/product-detail/Speakers_FUET-FS40DS0430-H18-8_C969979.html) | $1.1980 | $5991.1980
48 | Battery | Peripheral | 803450 3.7V 1500mAh Lithium Polymer Rechargeable Battery For MP3 GPS Massager Camera Power Bank Laptop Speaker Lipo Li ion Cell | - | - | - | - | - | - | 1 | 5000 | 5000 | Aliexpress (https://vi.aliexpress.com/item/1005006415551699.html) | $3.0800 | $15400.0000
49 | Charger | Peripheral | Universal 5V 1A 2A Type C USB Charger Mobile Phone Wall Travel Power Adapter Charger EU/US Plug For Huawei Xiaomi iPhone Samsung (2A Rating Selected) | - | - | - | - | - | - | 1 | 5000 | 1 | Aliexpress (https://vi.aliexpress.com/item/1005005257036835.html) | $0.6600 | $0.6600
50 | Screw | Peripheral | M2 Thread Length 16mm/ Head Dia 4mm | - | M2 (16mm) | - | - | - | - | 3 | 15000 | 15050 | Aliexpress (https://vi.aliexpress.com/item/32810852732.html?pdp_npi=4) | $0.0254 | $382.2700
51 |  |  | M3 Thread Length 20mm/ Head Dia 5.6mm | - | M3 (20mm) | - | - | - | - | 2 | 10000 | 10050 | Aliexpress (https://vi.aliexpress.com/item/32810852732.html?pdp_npi=4) | $0.0368 | $369.8400
52 |  |  | M Thread Length 4mm/ Head Dia 5.6mm | - | M3 (4mm) | - | - | - | - | 4 | 20000 | 20050 | Aliexpress (https://vi.aliexpress.com/item/32810852732.html?pdp_npi=4) | $0.0144 | $288.7200
 |  |  |  |  |  |  |  |  |  |  |  | Total Component Cost |  |  | $92629.77
 |  |  |  |  |  |  |  |  |  |  |  | Single Board Cost |  |  | $18.53
