Zain-Ul-Islam-Siddiqui/Smart-IoT-Audio-Streaming-System/(list of files, cad)

Other CAD files:
Design Files/IoT-Speaker-v1.4/Supporting Files/IOT_Speaker-PCB-v1.4.DWG
