Zain-Ul-Islam-Siddiqui/Smart-IoT-Audio-Streaming-System/Design Files/IoT-Speaker-v1.4/Schematics/Schematic_IoT-Speaker-v1.4.pdf

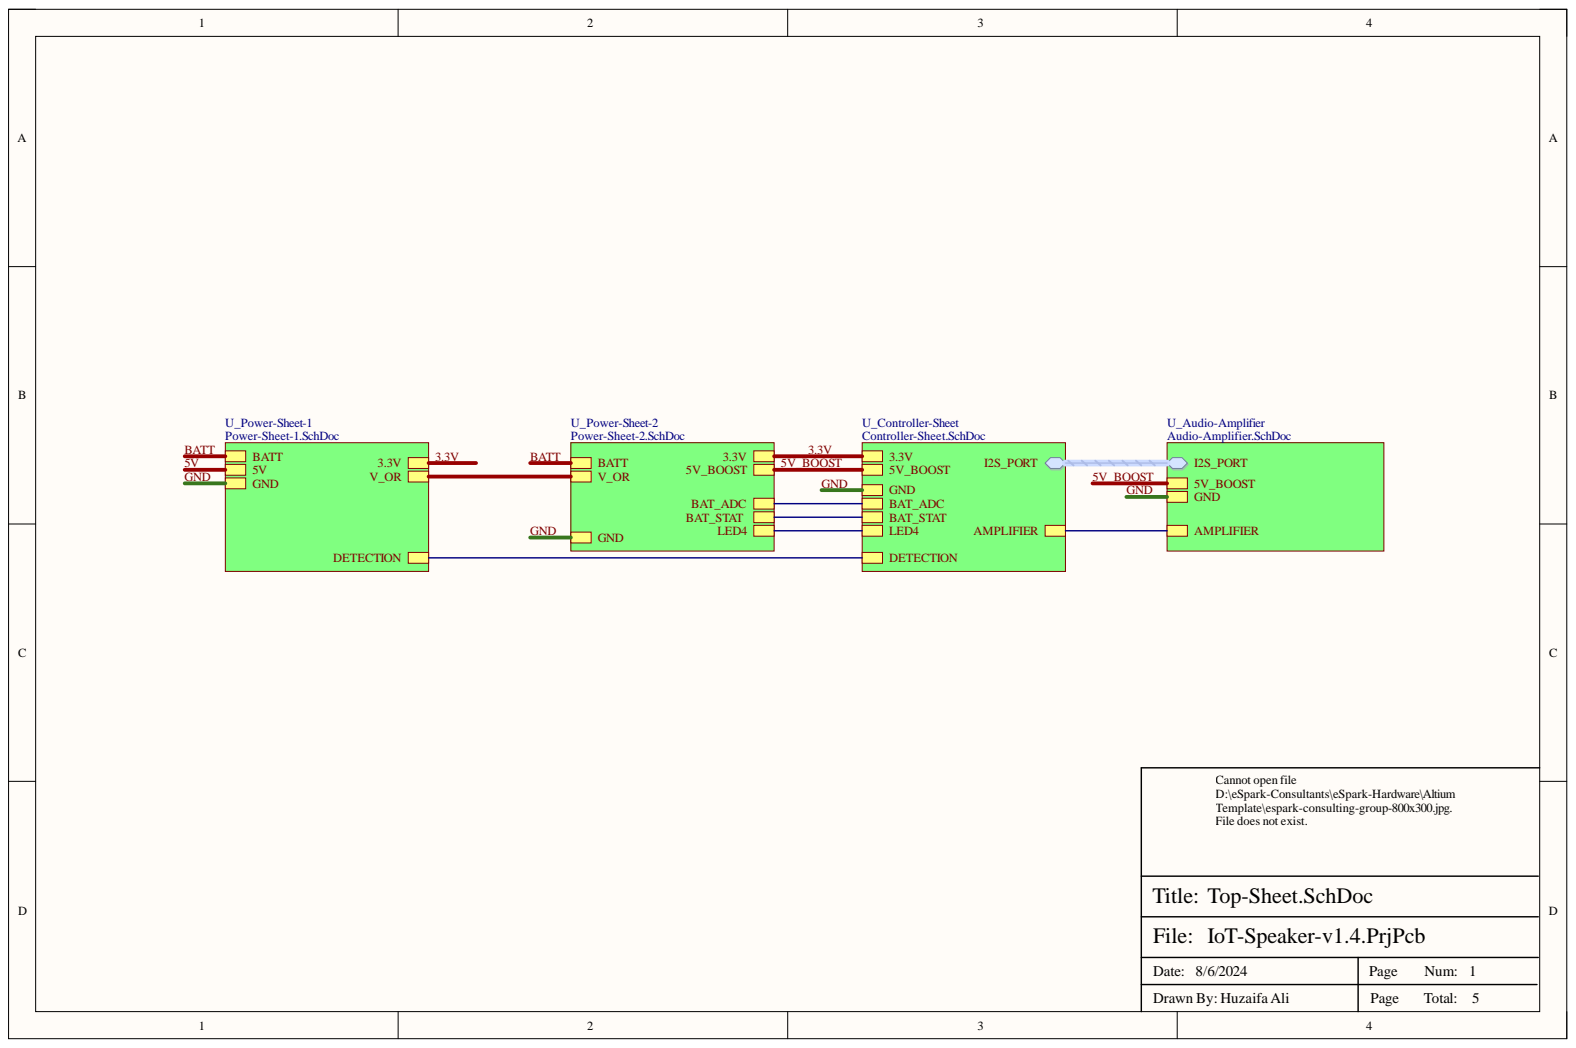
[picture p9: page 1]

IoT-Speaker-v1.4.PrjPcb Top-Sheet.SchDoc

Dat e : 8 / 6 / 2 0 2 4 | Pag e N u m : 15

D raw n B y : H uzai fa A l i | Pag e To t al :

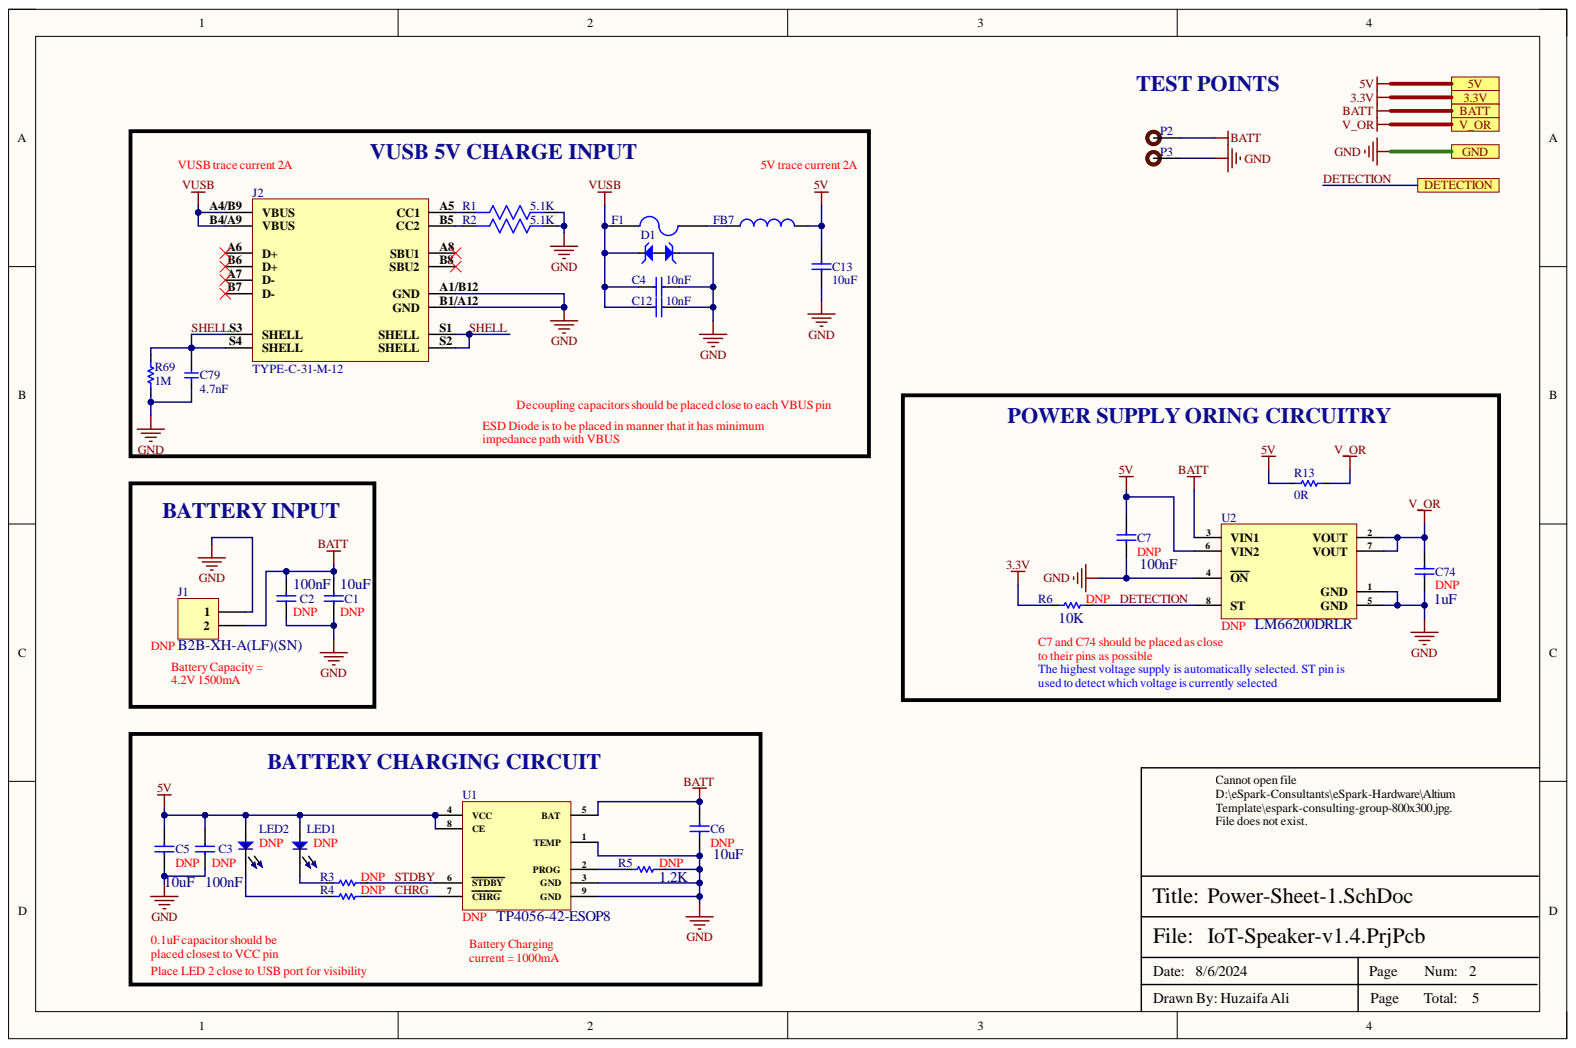
[picture p10: page 2]

Decoupling capacitors should be placed close to each VBUS pin

POWER SUPPLY ORING CIRCUITRY

ESD Diode is to be placed in manner that it has minimum
impedance path with VBUS

GND C7 and C74 should be placed as close
to their pins as possible
The highest voltage supply is automatically selected. ST pin is
used to detect which voltage is currently selected

Cannot open file
D:\eSpark-Consultants\eSpark-Hardware\Altium
Template\espark-consulting-group-800x300.jpg.
File does not exist.

0.1uF capacitorshould be
placed closest to VCC pin
Place LED 2 close to USB port for visibility

Date: 8/6/2024 | Page Num: 2

Drawn By: Huzaifa Ali | Page Total: 5

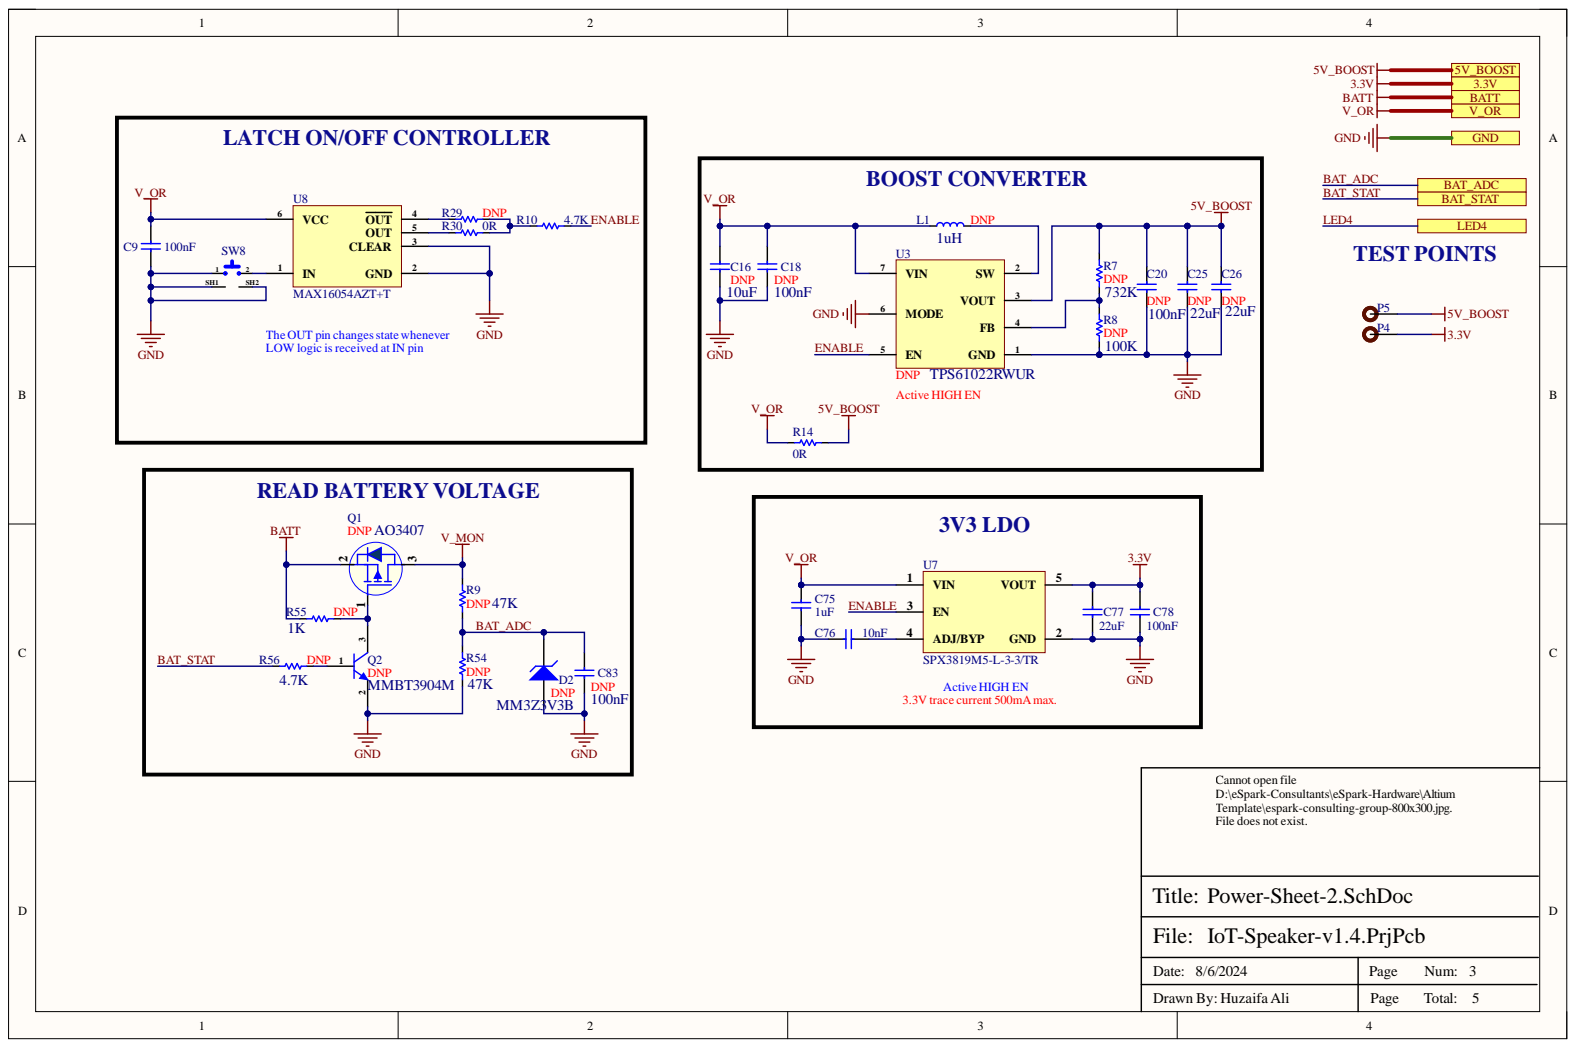
[picture p11: page 3]

LATCH ON/OFF CONTROLLER

The OUT pin changes state whenever
LOW logic is received at IN pin

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

Date: 8/6/2024 | Page Num: 3

Drawn By: Huzaifa Ali | Page Total: 5

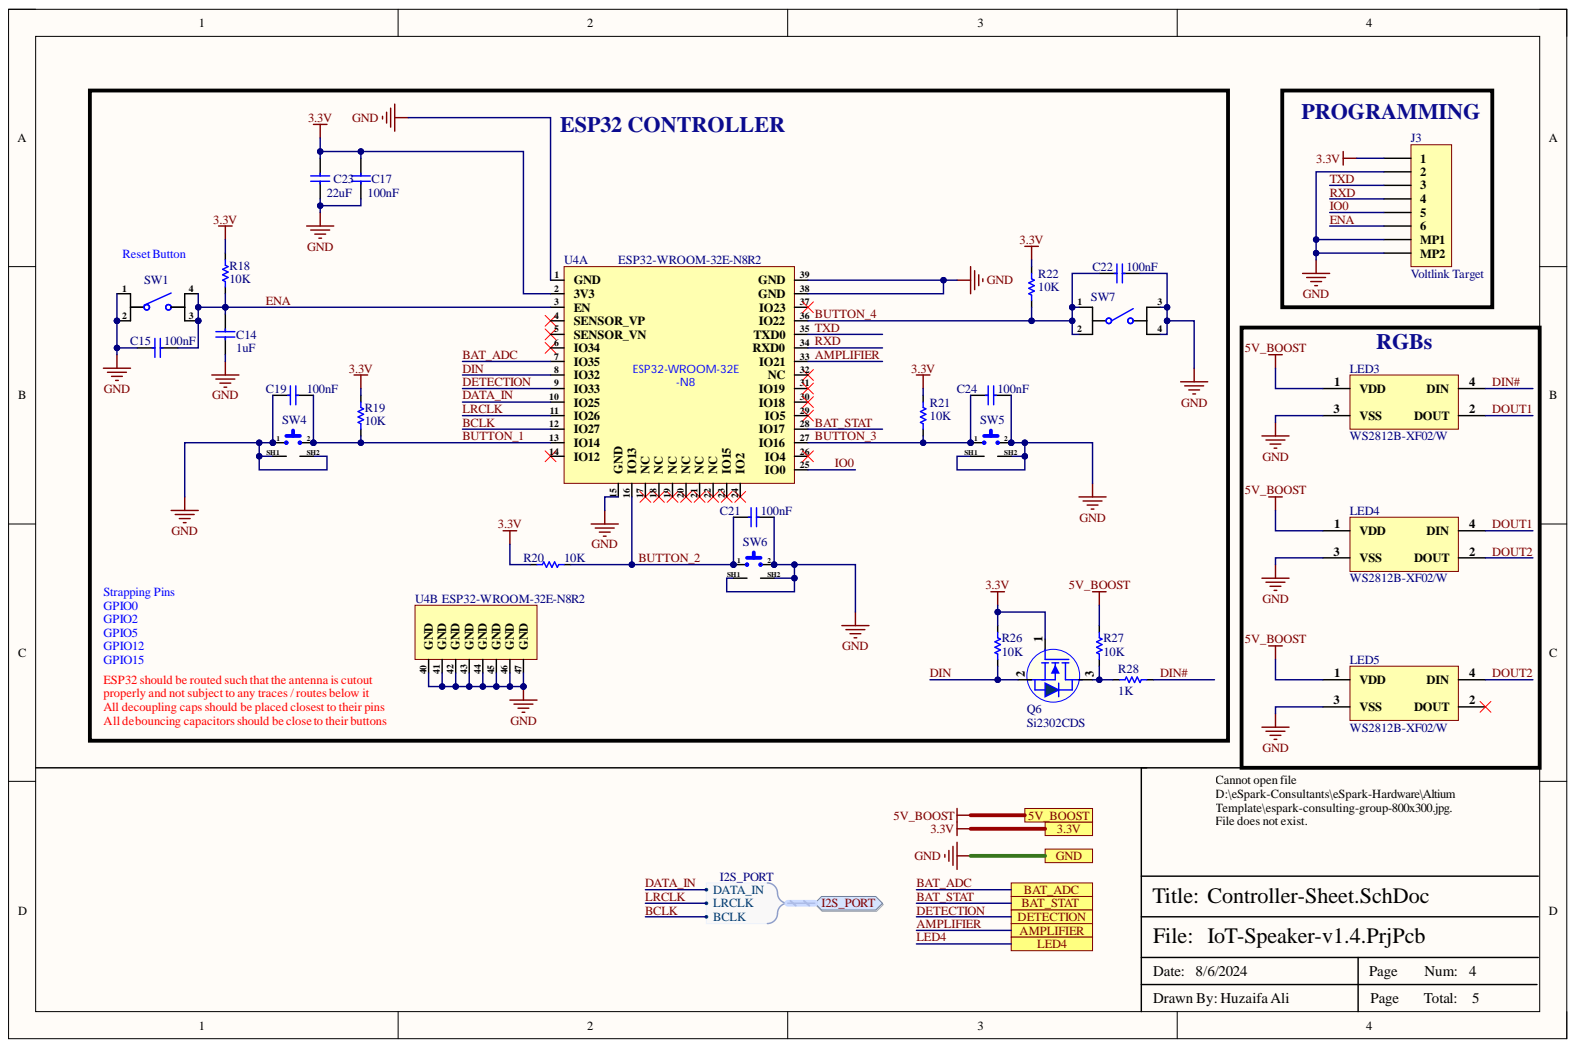
[picture p12: page 4]

Strapping Pins
GPIO0
GPIO2
GPIO5
GPIO12
GPIO15
ESP32 should be routed such that the antenna is cutout
properly and not subject to any traces / routes below it
All decoupling caps should be placed closest to their pins
All debouncing capacitors should be close to their buttons

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

Date: 8/6/2024 | Page Num: 4

Drawn By: Huzaifa Ali | Page Total: 5

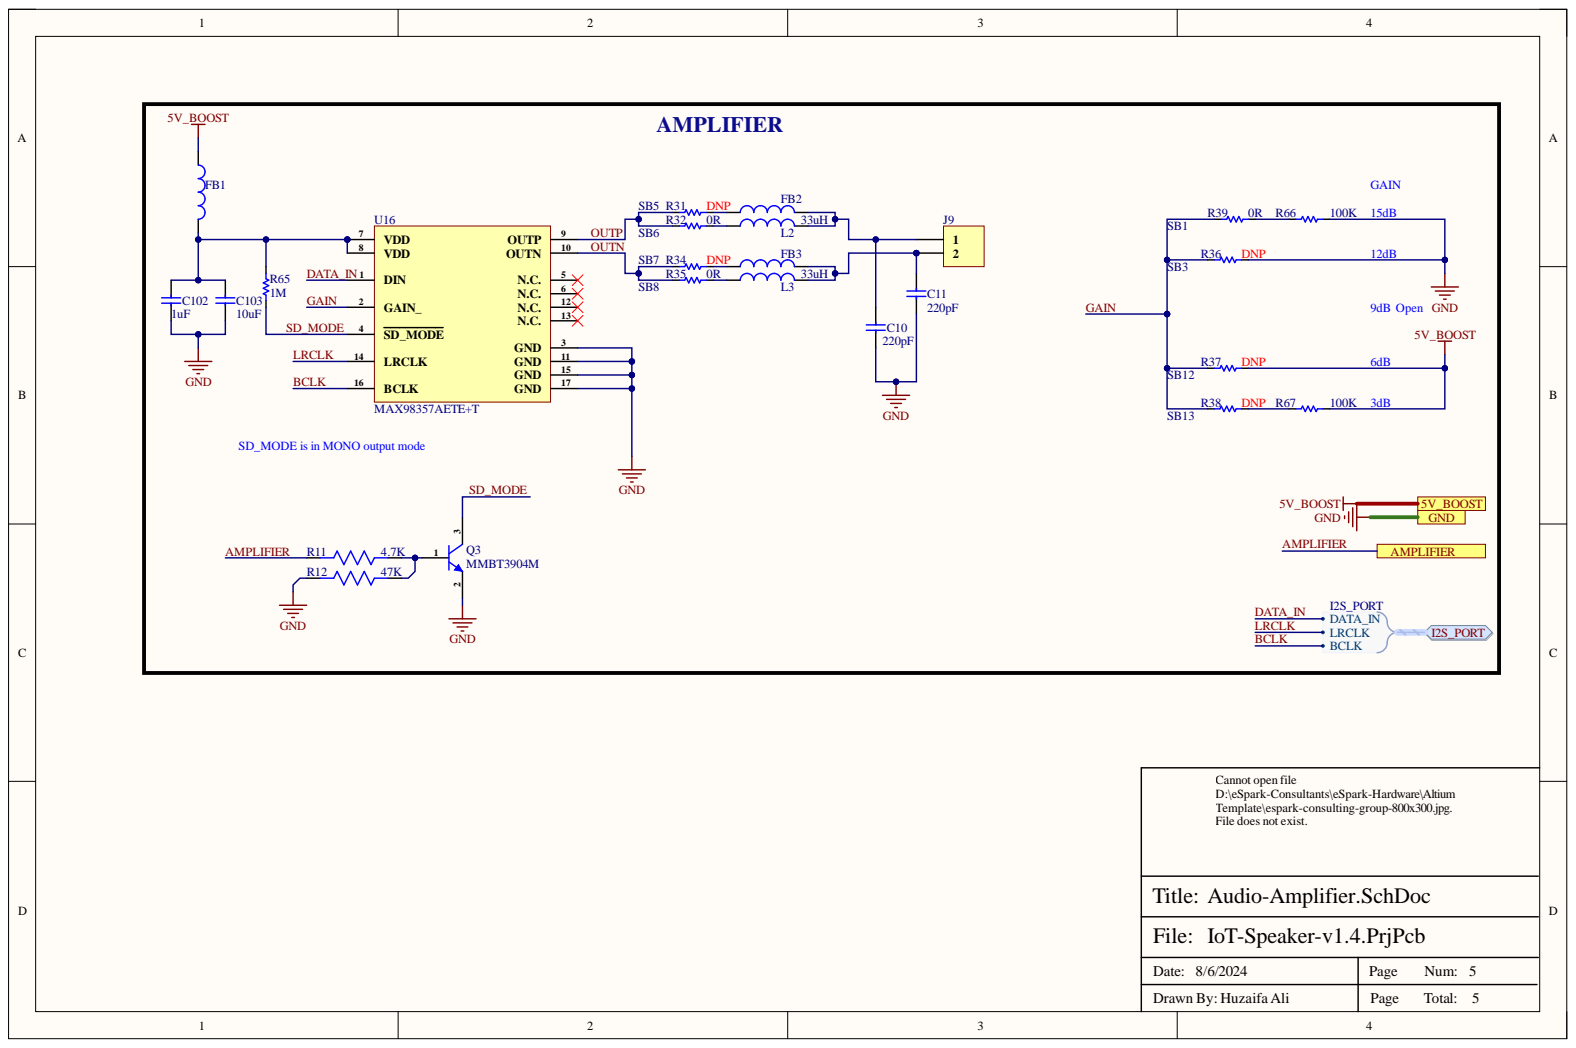
[picture p13: page 5]

SD_MODE is in MONO output mode

Dat e : 8 / 6 / 2 0 2 4 | Pag e N u m : 55

D raw n B y : H uzai fa A l i | Pag e To t al :
