Zain-Ul-Islam-Siddiqui/Smart-IoT-Audio-Streaming-System/(list of files, drawings)

Other design files:
Design Files/IoT-Speaker-v1.4/Audio-Amplifier.SchDoc
Design Files/IoT-Speaker-v1.4/Controller-Sheet.SchDoc
Design Files/IoT-Speaker-v1.4/IoT-Speaker-v1.4.PrjPcb
Design Files/IoT-Speaker-v1.4/Power-Sheet-1.SchDoc
Design Files/IoT-Speaker-v1.4/Power-Sheet-2.SchDoc
Design Files/IoT-Speaker-v1.4/Top-Sheet.SchDoc
